bot-hoven/bot-hoven-electrical/README.md

# Bot-Hoven Electrical Repository

The electrical schematics for the bot-hoven hand PCB (left_hand) and controller PCB (mainpcb).
