bot-hoven/bot-hoven-electrical/Schematics/v1 As-Builts/Hand PCB v1 AS-BUILT.pdf

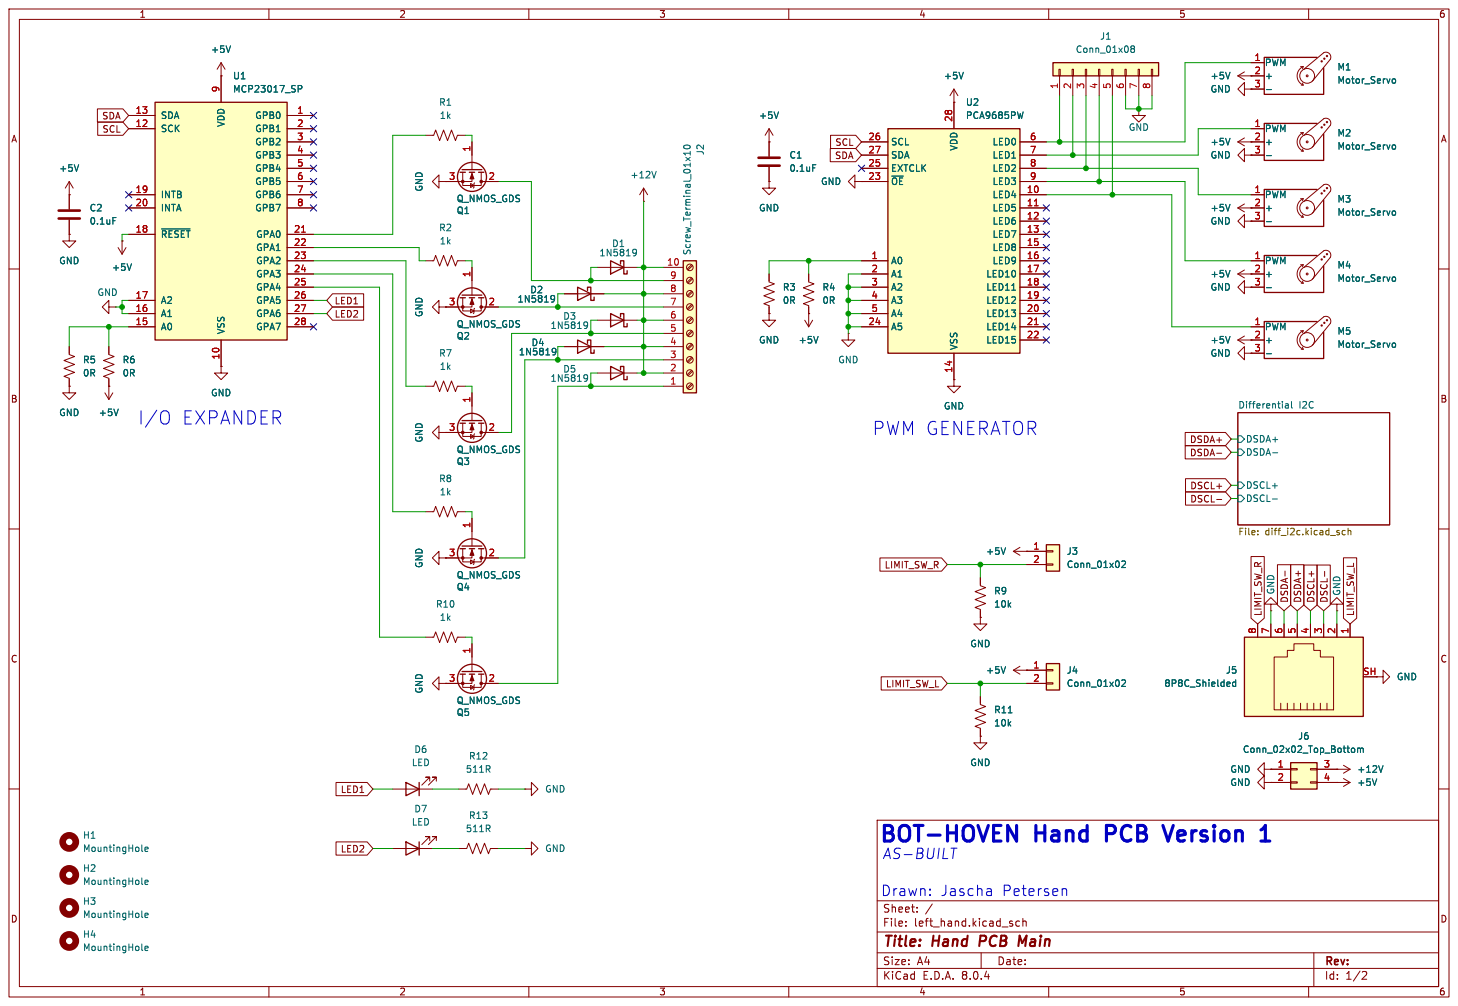
[picture p1: page 1]

BOT-HOVEN Hand PCB Version 1
AS-BUILT

Id: 1/2 Title: Hand PCB Main

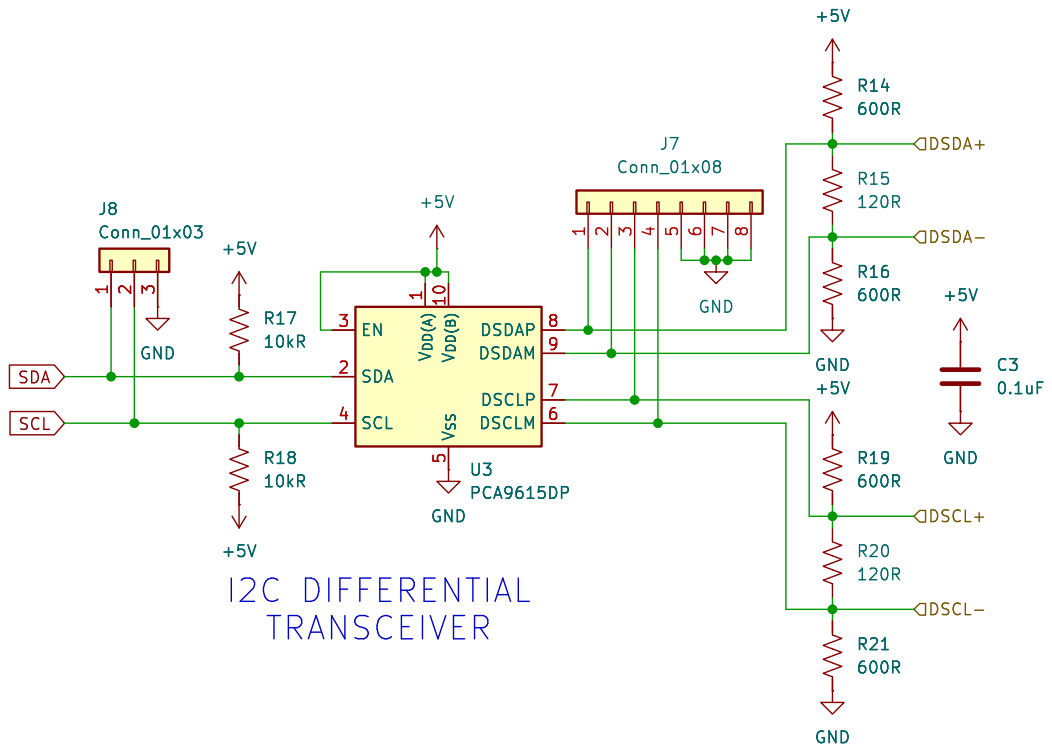
[picture p2: page 2]

DSCL- DSCL+ DSDA- DSDA+ SCL SDA
