bot-hoven/bot-hoven-electrical/Schematics/v1 As-Builts/Main PCB v1 AS-BUILT.pdf

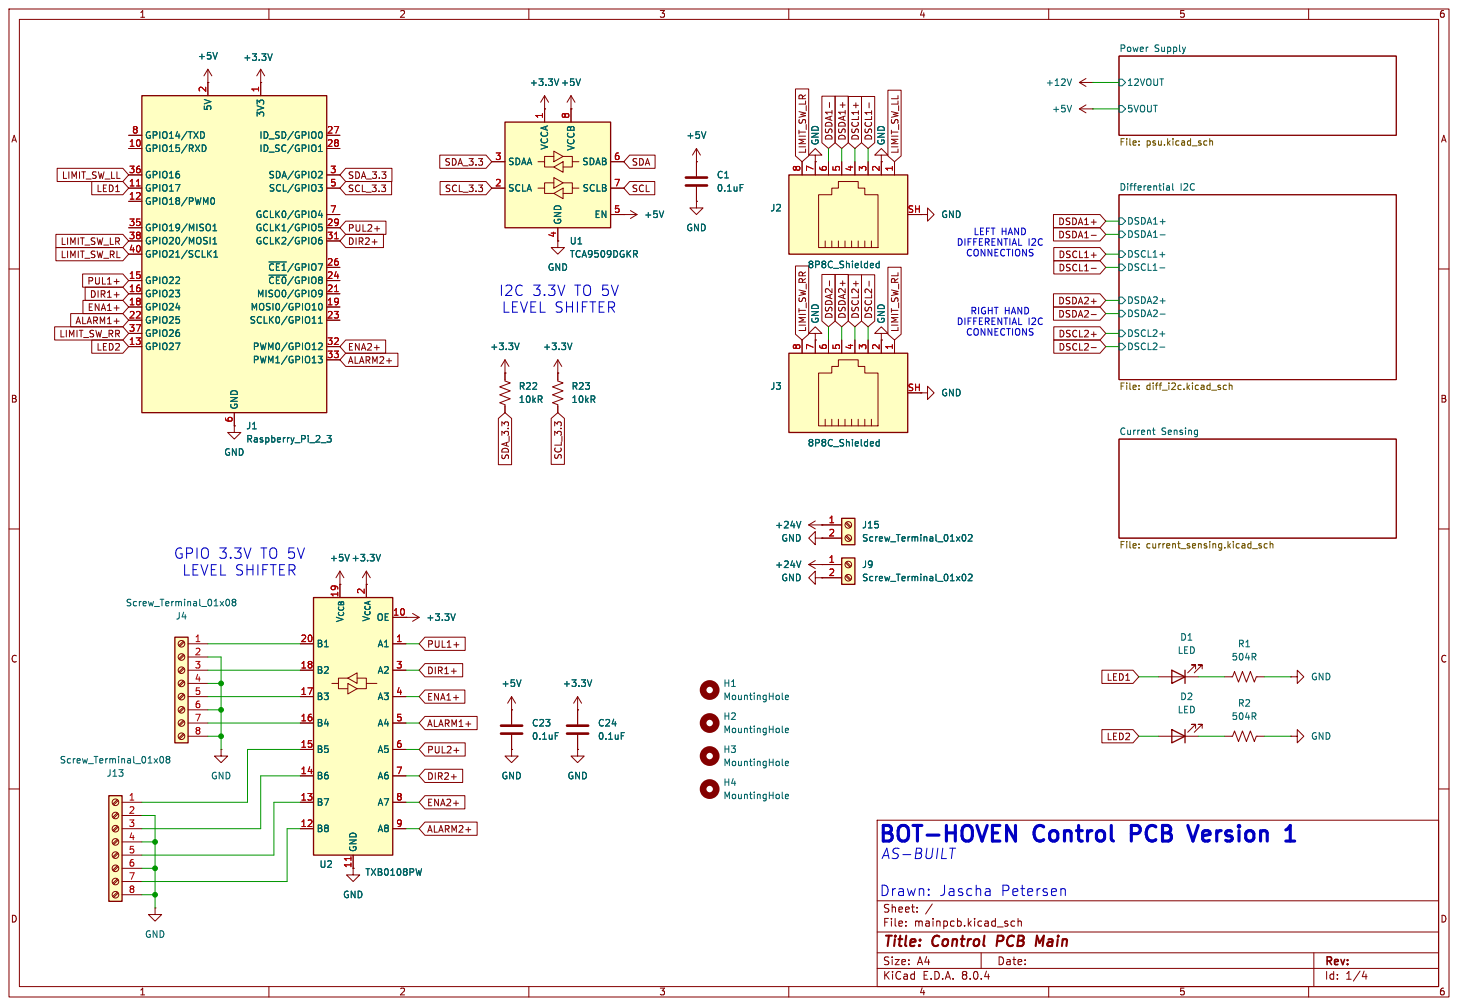
[picture p3: page 1]

6 GCLK0/GPIO4 7 GPIO14/TXD 8 GND GND GND

4 EN 5 SDAB 6 SCLB 7 VCCB

CONNECTIONS BOT-HOVEN Control PCB Version 1

Drawn: Jascha Petersen
File: mainpcb.kicad_sch Sheet: /
Id: 1/4 Title: Control PCB Main

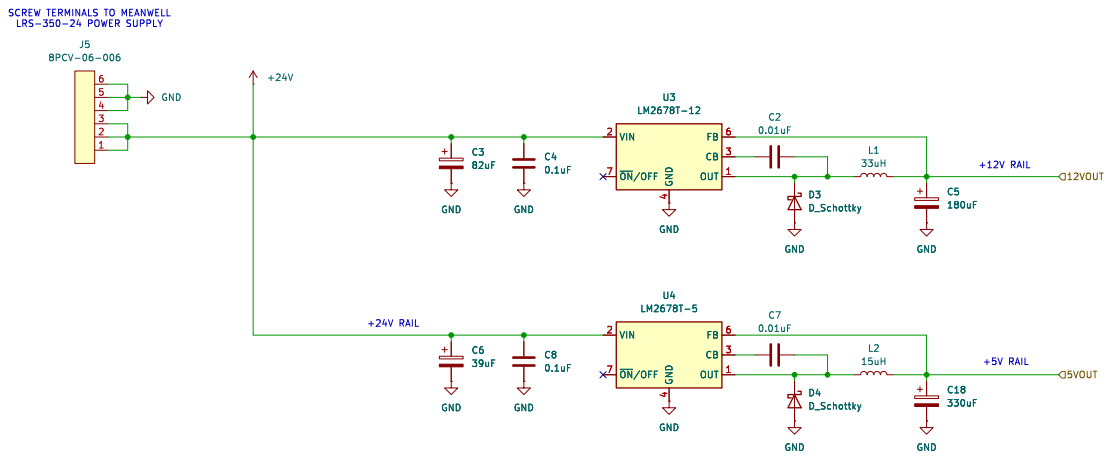
[picture p4: page 2]

SCREW TERMINALS TO MEANWELL

4 FB 6 ~{ON}/OFF 7 GND

+12V RAIL +5V RAIL AS-BUILT

Id: 2/4 Title: Control PCB PSU

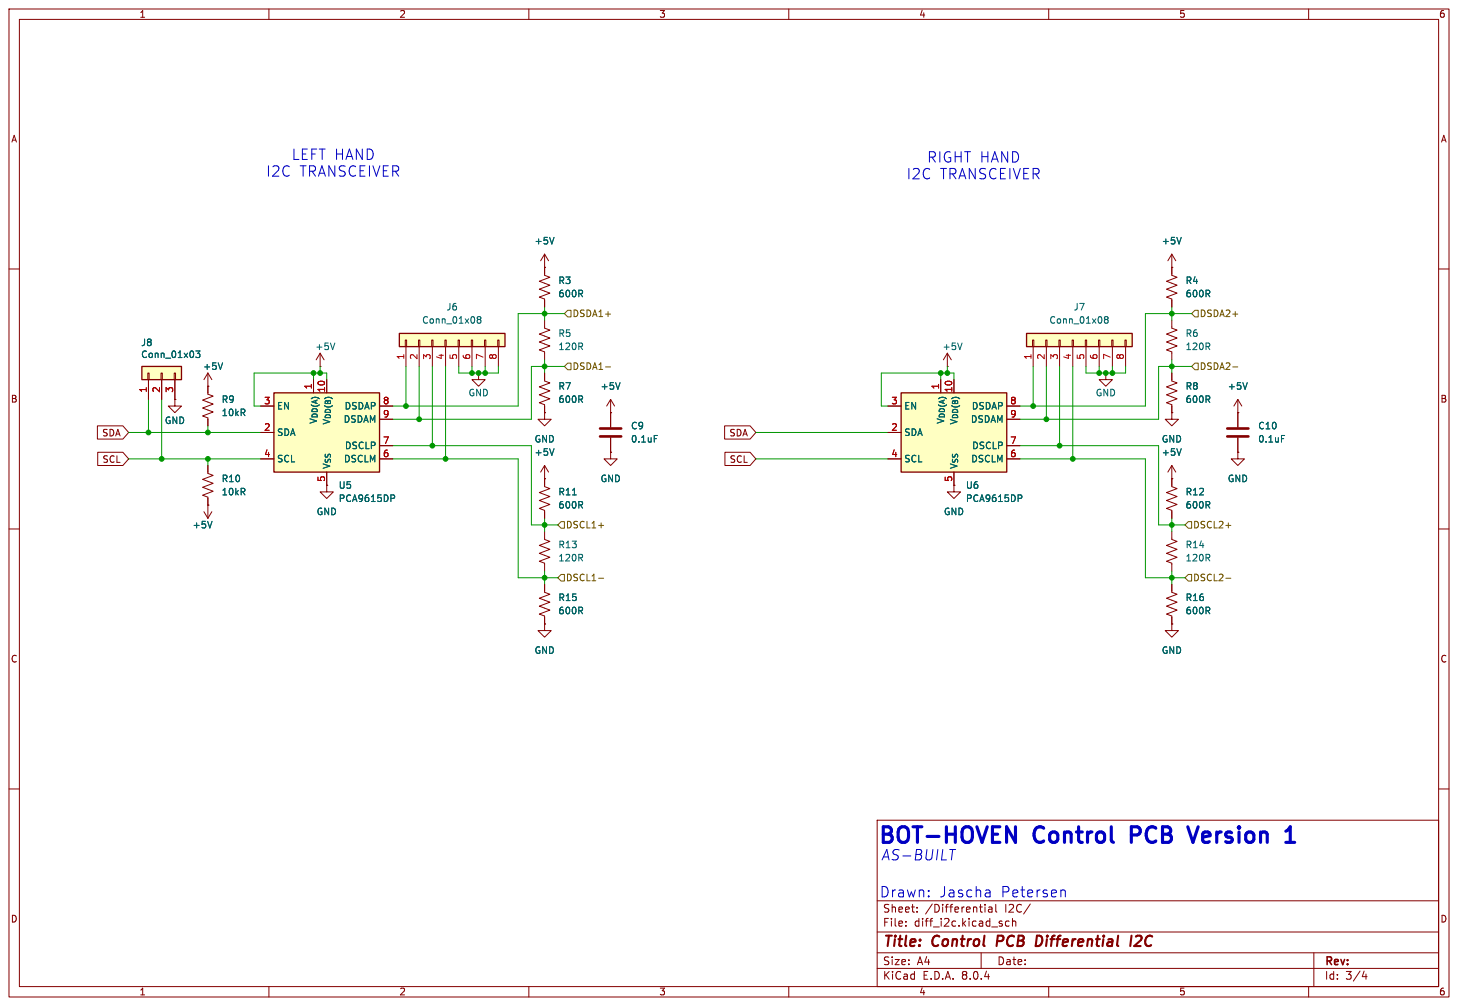
[picture p5: page 3]

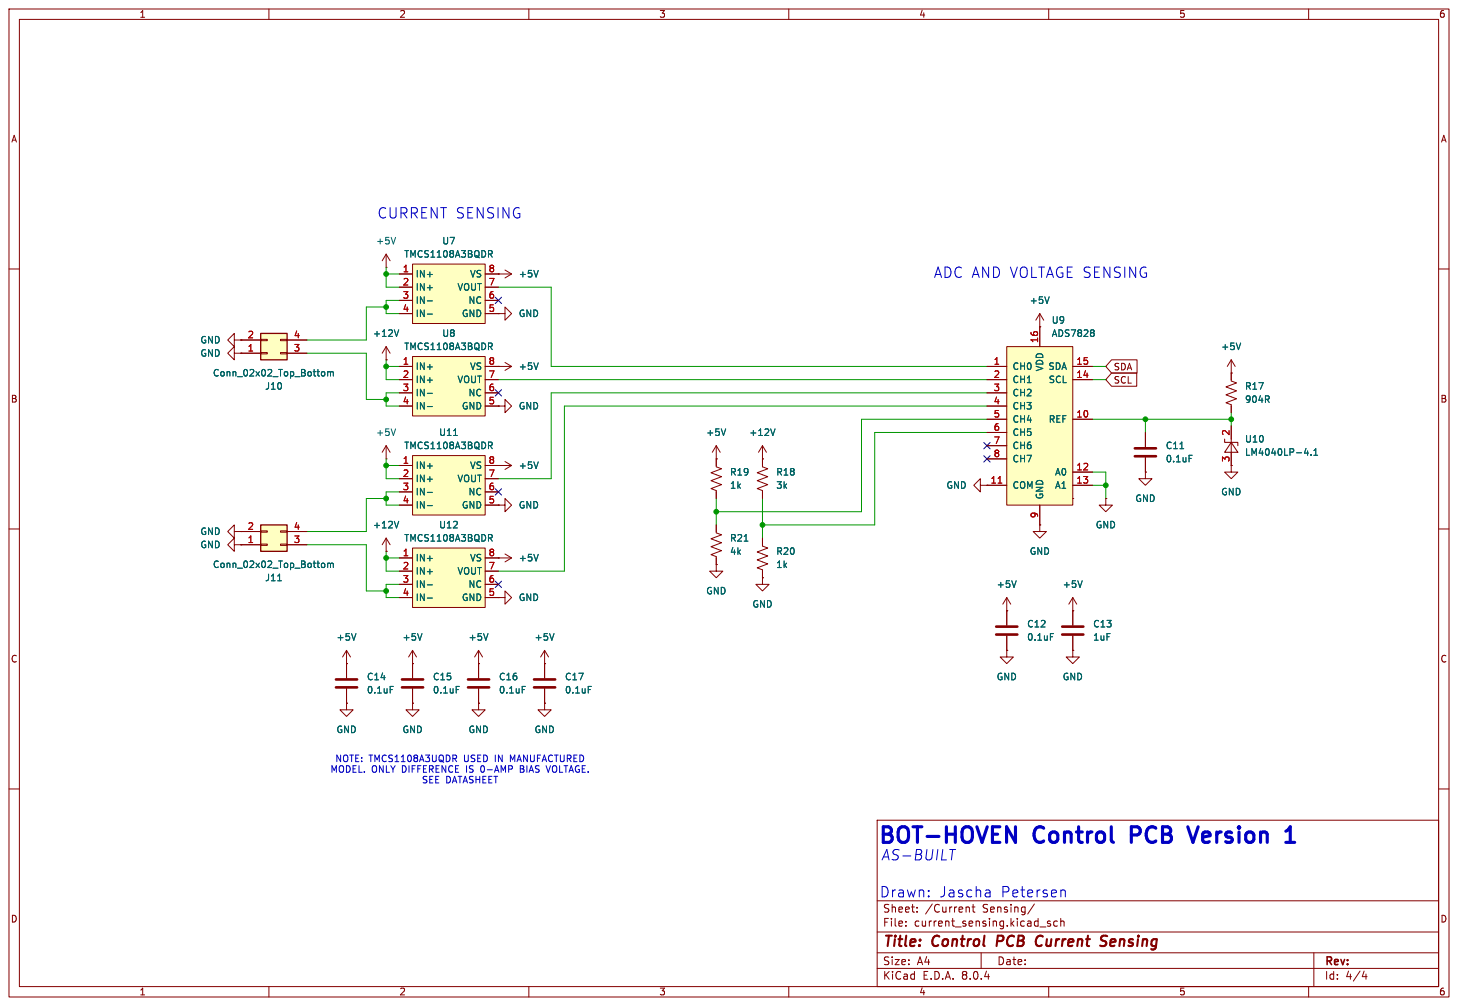
[picture p6: page 4]

2 3 U9ADS7828 CH0 1 REF 10 COM 11 A0 12 A1 13 SCL 14 SDA 15 VDD 16 CH1 2 CH2 3 CH3 4 CH4 5 CH5 6 CH6 7 CH7 8 GND

BOT-HOVEN Control PCB Version 1

Id: 4/4 Title: Control PCB Current Sensing
