bot-hoven/bot-hoven-electrical/v2/control_pcb/control_pcb.kicad_pcb

## KiCad design v2/control_pcb/control_pcb.kicad_pcb (2025-03-05)

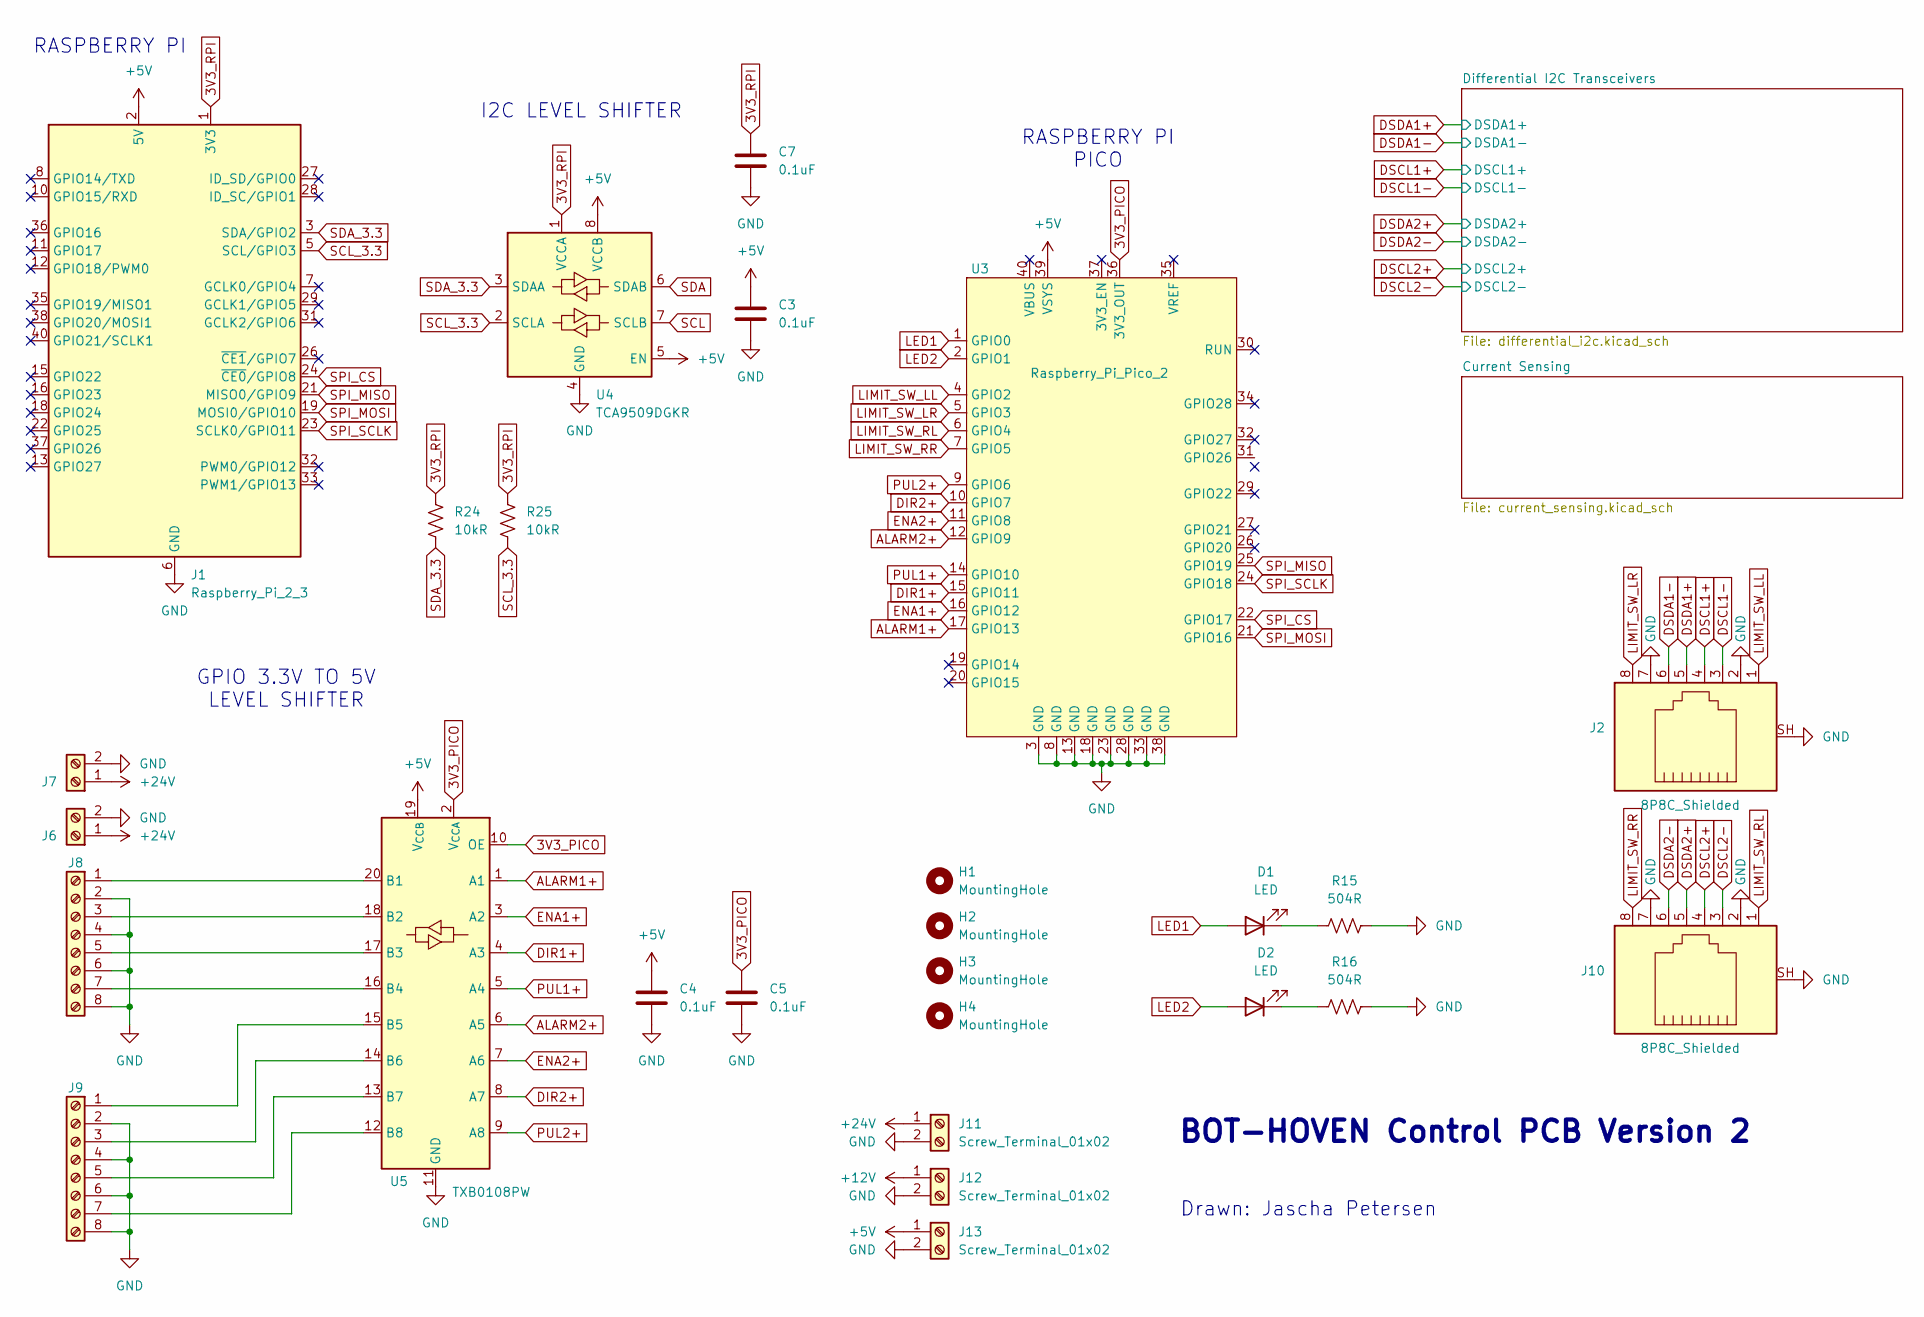
[picture p7: schematic control_pcb.kicad_sch]

Parts:
C3, C4, C5, C7: 0.1uF; C_Rect_L4.6mm_W2.0mm_P2.50mm_MKS02_FKP02
D1, D2: LED; LED_D5.0mm_Clear
H1, H2, H3, H4: MountingHole; MountingHole_4.3mm_M4
J1: Raspberry_Pi_2_3; PinHeader_2x20_P2.54mm_Vertical
J2, J10: 8P8C_Shielded; RJ45_Amphenol_54602-x08_Horizontal
J6, J7, J11, J12, J13: Screw_Terminal_01x02; TerminalBlock_Phoenix_PT-1,5-2-5.0-H_1x02_P5.00mm_Horizontal
J8, J9: Screw_Terminal_01x08; TerminalBlock_Phoenix_PT-1,5-8-5.0-H_1x08_P5.00mm_Horizontal
R15, R16: 504R; R_Axial_DIN0207_L6.3mm_D2.5mm_P10.16mm_Horizontal
R24, R25: 10kR; R_Axial_DIN0207_L6.3mm_D2.5mm_P10.16mm_Horizontal
U3: Raspberry_Pi_Pico_2; RaspberryPi_Pico_2_THT
U4: TCA9509DGKR; VSSOP-8_3x3mm_P0.65mm
U5: TXB0108PW; TSSOP-20_4.4x6.5mm_P0.65mm

Connections:
3V3_PICO: C5.1, U3.36 (3V3_OUT), U5.2 (V_{CCA}), U5.10 (OE)
3V3_RPI: C7.1, J1.1 (3V3), J1.17 (3V3), R24.1, R25.1, U4.1 (VCCA)
+5V: C3.1, C4.1, J1.2 (5V), J1.4 (5V), J13.1, U3.39 (VSYS), U4.5 (EN), U4.8 (VCCB), U5.19 (V_{CCB}); also elsewhere on the board
+12V: J12.1; also elsewhere on the board
+24V: J6.1, J7.1, J11.1; also elsewhere on the board
ALARM1+: U3.17 (GPIO13), U5.1 (A1)
ALARM2+: U3.12 (GPIO9), U5.6 (A5)
DIR1+: U3.15 (GPIO11), U5.4 (A3)
DIR2+: U3.10 (GPIO7), U5.8 (A7)
DSCL1+: J2.4; also elsewhere on the board
DSCL1-: J2.3; also elsewhere on the board
DSCL2+: J10.4; also elsewhere on the board
DSCL2-: J10.3; also elsewhere on the board
DSDA1+: J2.5; also elsewhere on the board
DSDA1-: J2.6; also elsewhere on the board
DSDA2+: J10.5; also elsewhere on the board
DSDA2-: J10.6; also elsewhere on the board
ENA1+: U3.16 (GPIO12), U5.3 (A2)
ENA2+: U3.11 (GPIO8), U5.7 (A6)
GND: C3.2, C4.2, C5.2, C7.2, J1.6 (GND), J1.9 (GND), J1.14 (GND), J1.20 (GND), J1.25 (GND), J1.30 (GND), J1.34 (GND), J1.39 (GND), J2.2, J2.7, J2.SH, J6.2, J7.2, J8.2, J8.4, J8.6, J8.8, J9.2, J9.4, J9.6, J9.8, J10.2, J10.7, J10.SH, J11.2, J12.2, J13.2, R15.2, R16.2, U3.3 (GND), U3.8 (GND), U3.13 (GND), U3.18 (GND), U3.23 (GND), U3.28 (GND), U3.33 (GND), U3.38 (GND), U4.4 (GND), U5.11 (GND); also elsewhere on the board
LED1: D1.2 (A), U3.1 (GPIO0)
LED2: D2.2 (A), U3.2 (GPIO1)
LIMIT_SW_LL: J2.1, U3.4 (GPIO2)
LIMIT_SW_LR: J2.8, U3.5 (GPIO3)
LIMIT_SW_RL: J10.1, U3.6 (GPIO4)
LIMIT_SW_RR: J10.8, U3.7 (GPIO5)
unnamed: D1.1 (K), R15.1
unnamed: D2.1 (K), R16.1
unnamed: J8.1, U5.20 (B1)
unnamed: J8.3, U5.18 (B2)
unnamed: J8.5, U5.17 (B3)
unnamed: J8.7, U5.16 (B4)
unnamed: J9.1, U5.15 (B5)
unnamed: J9.3, U5.14 (B6)
unnamed: J9.5, U5.13 (B7)
unnamed: J9.7, U5.12 (B8)
PUL1+: U3.14 (GPIO10), U5.5 (A4)
PUL2+: U3.9 (GPIO6), U5.9 (A8)
SCL: U4.7 (SCLB); also elsewhere on the board
SCL_3.3: J1.5 (SCL/GPIO3), R25.2, U4.2 (SCLA)
SDA: U4.6 (SDAB); also elsewhere on the board
SDA_3.3: J1.3 (SDA/GPIO2), R24.2, U4.3 (SDAA)
SPI_CS: J1.24 (~CE0/GPIO8), U3.22 (GPIO17)
SPI_MISO: J1.21 (MISO0/GPIO9), U3.25 (GPIO19)
SPI_MOSI: J1.19 (MOSI0/GPIO10), U3.21 (GPIO16)
SPI_SCLK: J1.23 (SCLK0/GPIO11), U3.24 (GPIO18)

Notes on the sheet:
BOT-HOVEN Control PCB Version 2
GPIO 3.3V TO 5V LEVEL SHIFTER
I2C LEVEL SHIFTER
Drawn: Jascha Petersen
RASPBERRY PI PICO
RASPBERRY PI

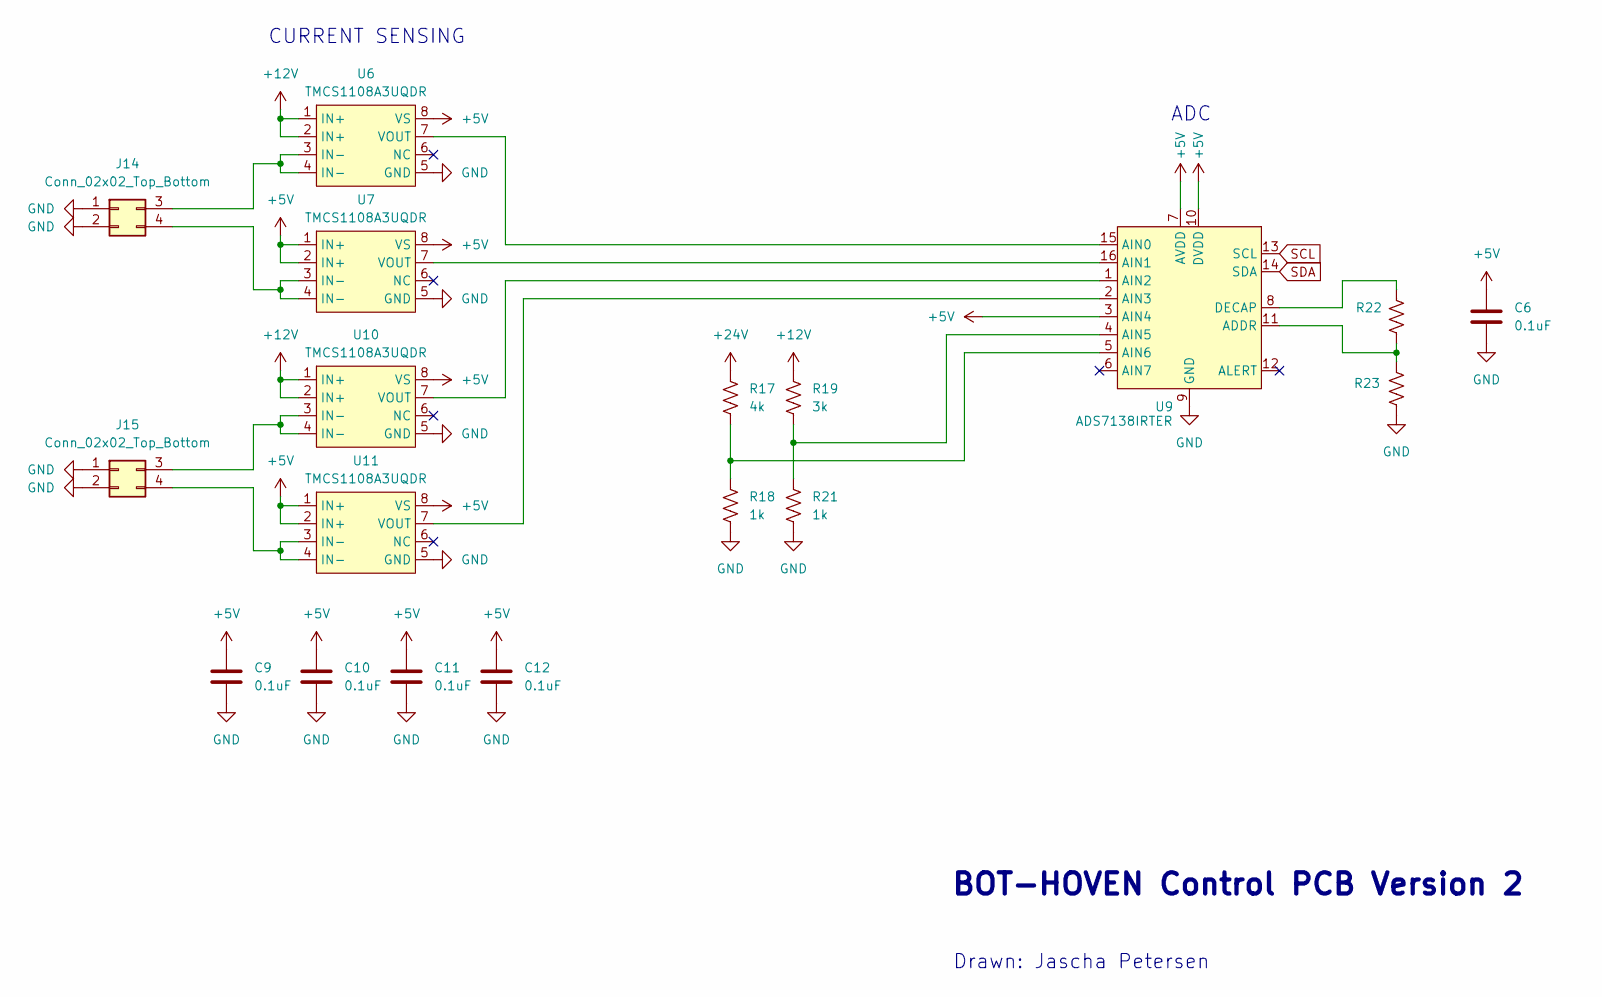
[picture p8: schematic current_sensing.kicad_sch]

Parts:
C6, C9, C10, C11, C12: 0.1uF; C_Rect_L4.6mm_W2.0mm_P2.50mm_MKS02_FKP02
J14, J15: Conn_02x02_Top_Bottom; Molex_Mini-Fit_Jr_5569-04A2_2x02_P4.20mm_Horizontal
R17: 4k; R_Axial_DIN0207_L6.3mm_D2.5mm_P10.16mm_Horizontal
R18, R21: 1k; R_Axial_DIN0207_L6.3mm_D2.5mm_P10.16mm_Horizontal
R19: 3k; R_Axial_DIN0207_L6.3mm_D2.5mm_P10.16mm_Horizontal
R22, R23: 0R; R_Axial_DIN0207_L6.3mm_D2.5mm_P10.16mm_Horizontal
U6, U7, U10, U11: TMCS1108A3UQDR; SOIC-8_3.9x4.9mm_P1.27mm
U9: ADS7138IRTER; WQFN-16-1EP_3x3mm_P0.5mm_EP1.68x1.68mm

Connections:
+5V: C6.1, C9.1, C10.1, C11.1, C12.1, U6.8 (VS), U7.1 (IN+), U7.2 (IN+), U7.8 (VS), U9.3 (AIN4), U9.7 (AVDD), U9.10 (DVDD), U10.8 (VS), U11.1 (IN+), U11.2 (IN+), U11.8 (VS); also elsewhere on the board
+12V: R19.1, U6.1 (IN+), U6.2 (IN+), U10.1 (IN+), U10.2 (IN+); also elsewhere on the board
+24V: R17.1; also elsewhere on the board
GND: C6.2, C9.2, C10.2, C11.2, C12.2, J14.1, J14.2, J15.1, J15.2, R18.2, R21.2, R23.2, U6.5 (GND), U7.5 (GND), U9.9 (GND), U10.5 (GND), U11.5 (GND); also elsewhere on the board
unnamed: J14.3, U6.3 (IN-), U6.4 (IN-)
unnamed: J14.4, U7.3 (IN-), U7.4 (IN-)
unnamed: J15.3, U10.3 (IN-), U10.4 (IN-)
unnamed: J15.4, U11.3 (IN-), U11.4 (IN-)
unnamed: U6.7 (VOUT), U9.15 (AIN0)
unnamed: U7.7 (VOUT), U9.16 (AIN1)
unnamed: R22.2, R23.1, U9.11 (ADDR)
unnamed: R19.2, R21.1, U9.4 (AIN5)
unnamed: R17.2, R18.1, U9.5 (AIN6)
unnamed: R22.1, U9.8 (DECAP)
unnamed: U9.1 (AIN2), U10.7 (VOUT)
unnamed: U9.2 (AIN3), U11.7 (VOUT)
SCL: U9.13 (SCL); also elsewhere on the board
SDA: U9.14 (SDA); also elsewhere on the board

Notes on the sheet:
ADC
CURRENT SENSING
Drawn: Jascha Petersen
BOT-HOVEN Control PCB Version 2

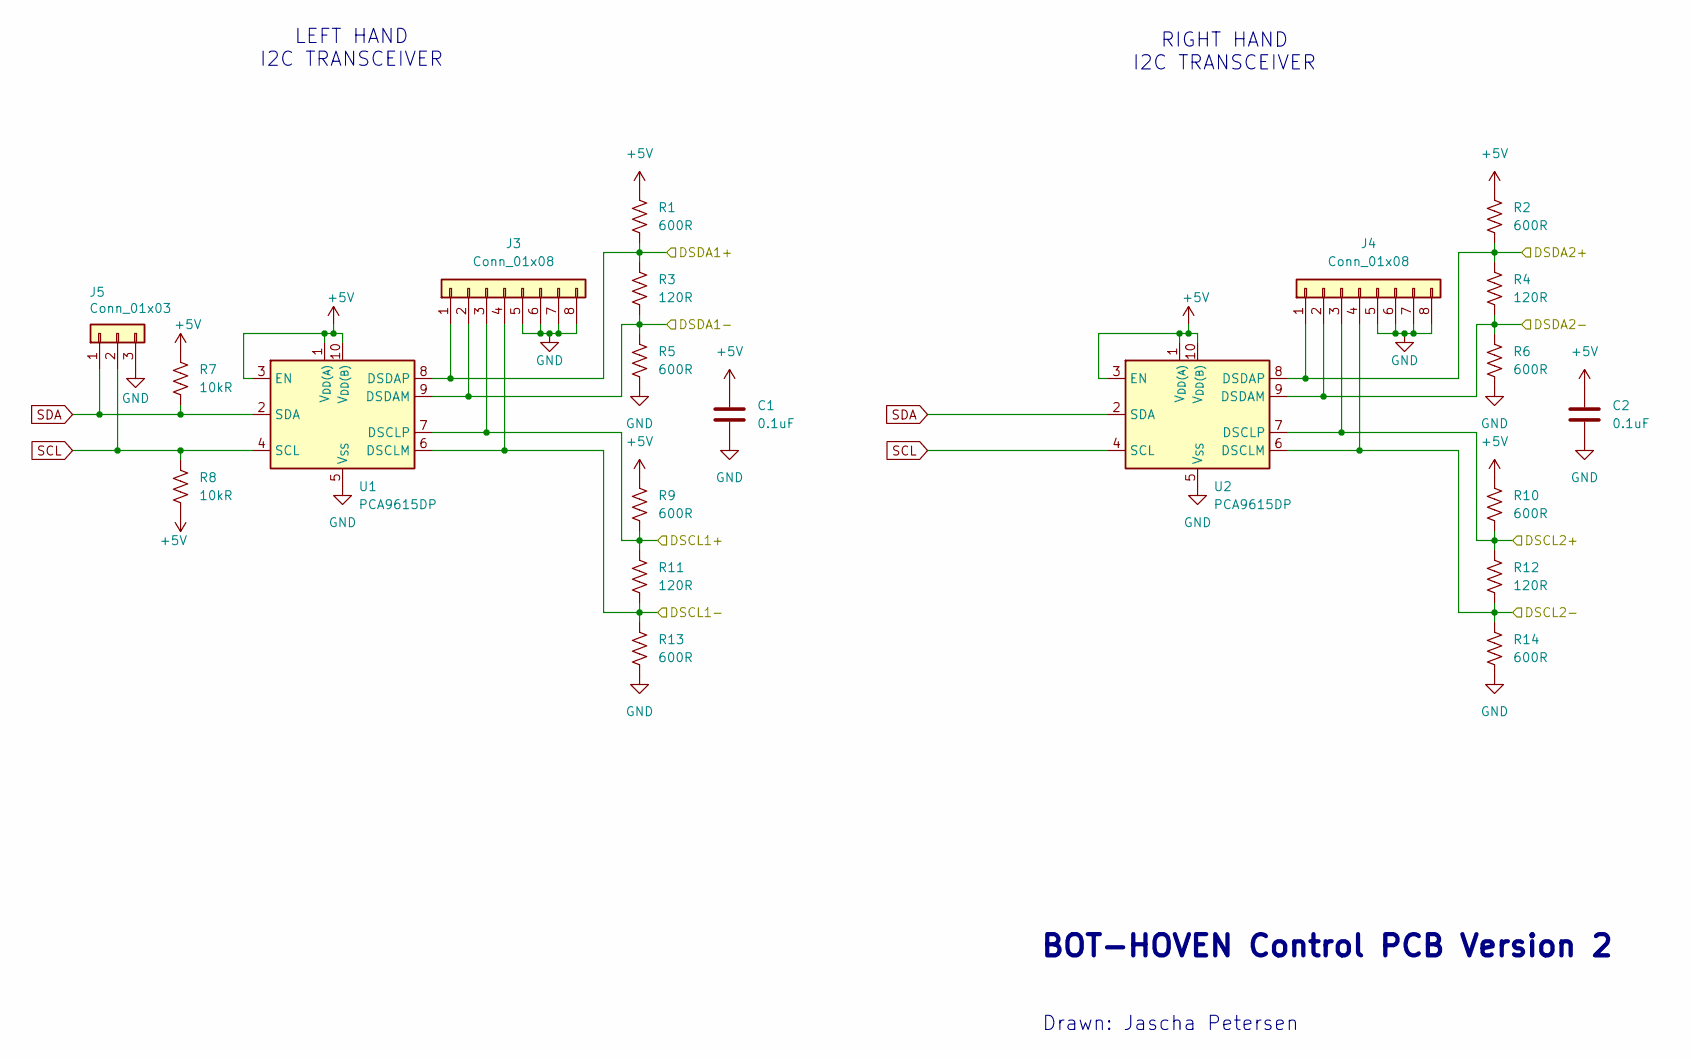
[picture p9: schematic differential_i2c.kicad_sch]

Parts:
C1, C2: 0.1uF; C_Rect_L4.6mm_W2.0mm_P2.50mm_MKS02_FKP02
J3, J4: Conn_01x08; PinHeader_1x08_P2.54mm_Vertical
J5: Conn_01x03; PinHeader_1x03_P2.54mm_Vertical
R1, R2, R5, R6, R9, R10, R13, R14: 600R; R_Axial_DIN0207_L6.3mm_D2.5mm_P10.16mm_Horizontal
R3, R4, R11, R12: 120R; R_Axial_DIN0207_L6.3mm_D2.5mm_P10.16mm_Horizontal
R7, R8: 10kR; R_Axial_DIN0207_L6.3mm_D2.5mm_P10.16mm_Horizontal
U1, U2: PCA9615DP; TSSOP-10_3x3mm_P0.5mm

Connections:
+5V: C1.1, C2.1, R1.1, R2.1, R7.1, R8.2, R9.1, R10.1, U1.1 (V_{DD(A)}), U1.3 (EN), U1.10 (V_{DD(B)}), U2.1 (V_{DD(A)}), U2.3 (EN), U2.10 (V_{DD(B)}); also elsewhere on the board
DSCL1+: J3.3, R9.2, R11.1, U1.7 (DSCLP); also elsewhere on the board
DSCL1-: J3.4, R11.2, R13.1, U1.6 (DSCLM); also elsewhere on the board
DSCL2+: J4.3, R10.2, R12.1, U2.7 (DSCLP); also elsewhere on the board
DSCL2-: J4.4, R12.2, R14.1, U2.6 (DSCLM); also elsewhere on the board
DSDA1+: J3.1, R1.2, R3.1, U1.8 (DSDAP); also elsewhere on the board
DSDA1-: J3.2, R3.2, R5.1, U1.9 (DSDAM); also elsewhere on the board
DSDA2+: J4.1, R2.2, R4.1, U2.8 (DSDAP); also elsewhere on the board
DSDA2-: J4.2, R4.2, R6.1, U2.9 (DSDAM); also elsewhere on the board
GND: C1.2, C2.2, J3.5, J3.6, J3.7, J3.8, J4.5, J4.6, J4.7, J4.8, J5.3, R5.2, R6.2, R13.2, R14.2, U1.5 (V_{SS}), U2.5 (V_{SS}); also elsewhere on the board
SCL: J5.2, R8.1, U1.4 (SCL), U2.4 (SCL); also elsewhere on the board
SDA: J5.1, R7.2, U1.2 (SDA), U2.2 (SDA); also elsewhere on the board

Notes on the sheet:
BOT-HOVEN Control PCB Version 2
RIGHT HAND I2C TRANSCEIVER
LEFT HAND I2C TRANSCEIVER
Drawn: Jascha Petersen

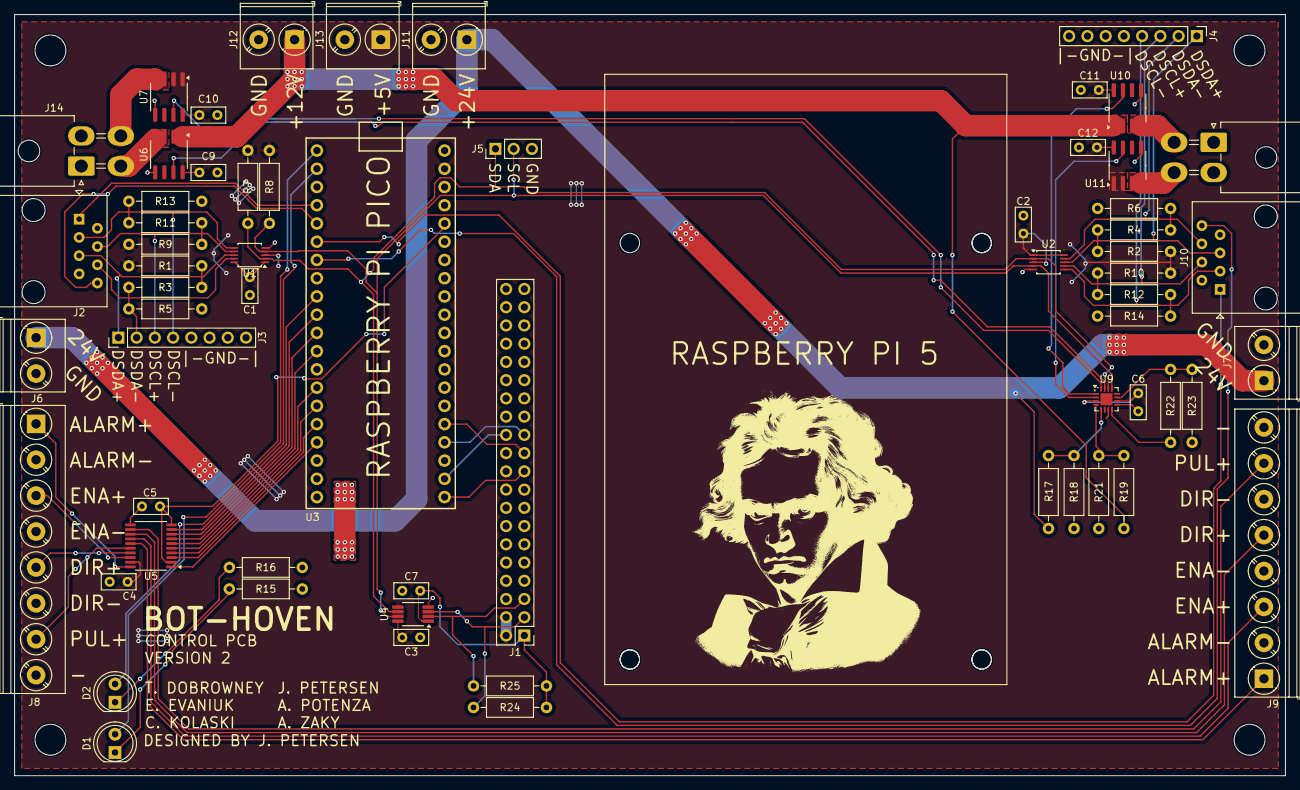
[picture p10: board control_pcb.kicad_pcb from above]

Board: 2 copper layers, 177.0 x 106.0 mm, 66 parts (0 on the bottom side), 58 nets.
