bot-hoven/bot-hoven-electrical/v2/hand_pcb/hand_pcb.kicad_pcb

## KiCad design v2/hand_pcb/hand_pcb.kicad_pcb (2025-03-05)

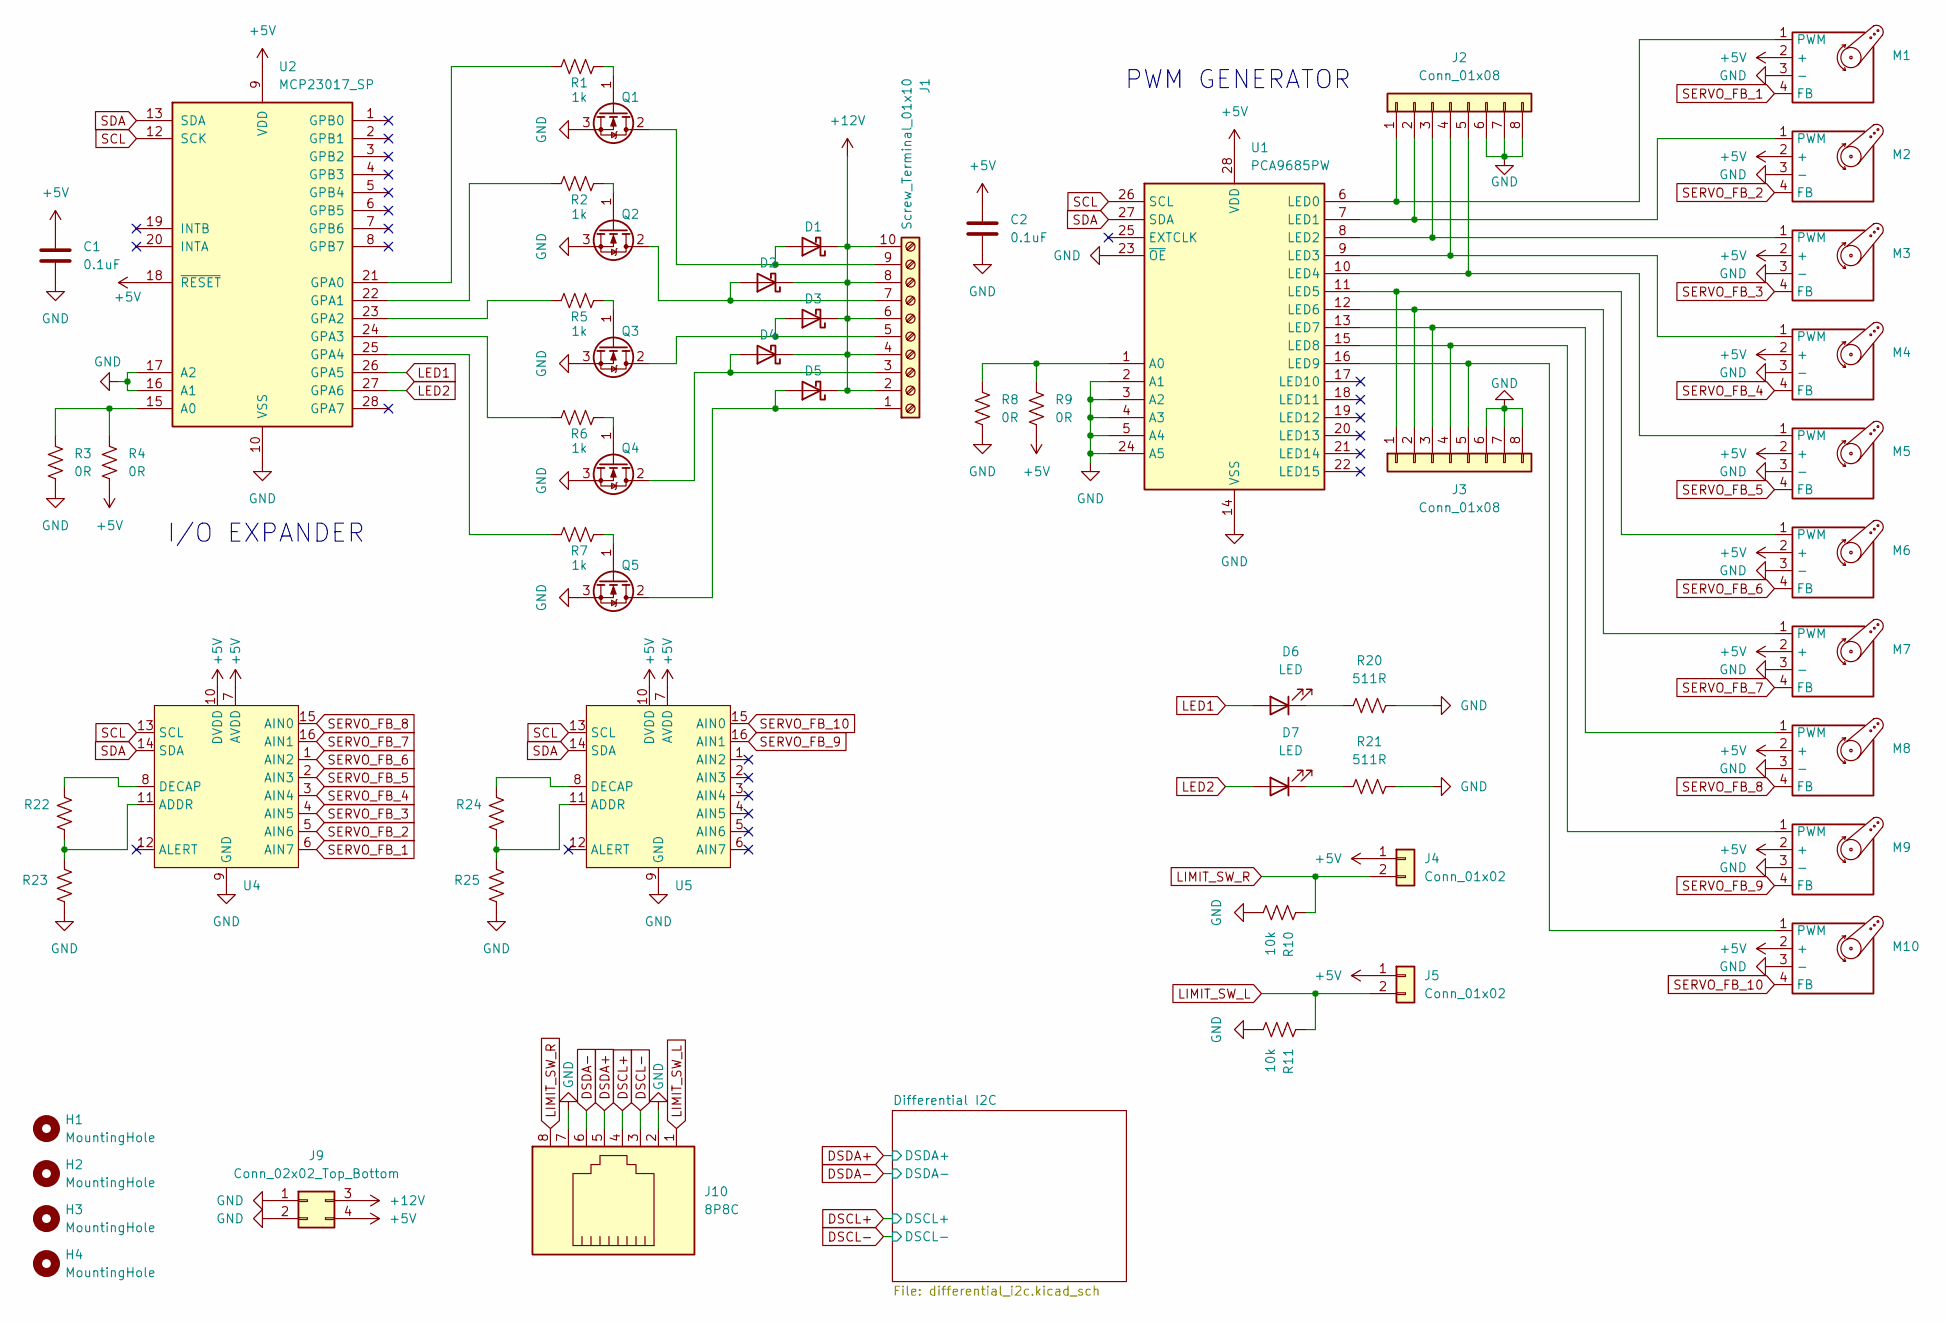
[picture p11: schematic hand_pcb.kicad_sch]

Parts:
C1, C2: 0.1uF; C_Disc_D3.4mm_W2.1mm_P2.50mm
D1, D2, D3, D4, D5: SB5100-T; D_DO-201AD_P12.70mm_Horizontal
D6, D7: LED; LED_D5.0mm_Clear
H1, H2, H3, H4: MountingHole; MountingHole_3.2mm_M3
J1: Screw_Terminal_01x10; TerminalBlock_Phoenix_PT-1,5-10-5.0-H_1x10_P5.00mm_Horizont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
J2, J3: Conn_01x08; PinHeader_1x08_P2.54mm_Vertical
J4, J5: Conn_01x02; JST_XH_S2B-XH-A_1x02_P2.50mm_Horizontal
J9: Conn_02x02_Top_Bottom; Molex_Mini-Fit_Jr_5569-04A2_2x02_P4.20mm_Horizontal
J10: 8P8C; RJ45_Amphenol_54602-x08_Horizontal
M1, M2, M3, M4, M5, M6, M7, M8, M9, M10: Motor_Servo_FB; PinHeader_1x04_P2.54mm_Vertical
Q1, Q2, Q3, Q4, Q5: Q_NMOS_GDS; TO-220-3_Vertical
R1, R2, R5, R6, R7: 1k; R_Axial_DIN0207_L6.3mm_D2.5mm_P10.16mm_Horizontal
R3, R4, R8, R9, R22, R23, R24, R25: 0R; R_Axial_DIN0207_L6.3mm_D2.5mm_P10.16mm_Horizontal
R10, R11: 10k; R_Axial_DIN0207_L6.3mm_D2.5mm_P10.16mm_Horizontal
R20, R21: 511R; R_Axial_DIN0207_L6.3mm_D2.5mm_P10.16mm_Horizontal
U1: PCA9685PW; TSSOP-28_4.4x9.7mm_P0.65mm
U2: MCP23017_SP; DIP-28_W7.62mm
U4, U5: WQFN-16-1EP_3x3mm_P0.5mm_EP1.68x1.68mm

Connections:
+5V: C1.1, C2.1, J4.1, J5.1, J9.4, M1.2 (+), M2.2 (+), M3.2 (+), M4.2 (+), M5.2 (+), M6.2 (+), M7.2 (+), M8.2 (+), M9.2 (+), M10.2 (+), R4.2, R9.2, U1.28 (VDD), U2.9 (VDD), U2.18 (~RESET), U4.7 (AVDD), U4.10 (DVDD), U5.7 (AVDD), U5.10 (DVDD); also elsewhere on the board
+12V: D1.1 (K), D2.1 (K), D3.1 (K), D4.1 (K), D5.1 (K), J1.2, J1.4, J1.6, J1.8, J1.10, J9.3
DSCL+: J10.4; also elsewhere on the board
DSCL-: J10.3; also elsewhere on the board
DSDA+: J10.5; also elsewhere on the board
DSDA-: J10.6; also elsewhere on the board
GND: C1.2, C2.2, J2.6, J2.7, J2.8, J3.6, J3.7, J3.8, J9.1, J9.2, J10.2, J10.7, M1.3 (-), M2.3 (-), M3.3 (-), M4.3 (-), M5.3 (-), M6.3 (-), M7.3 (-), M8.3 (-), M9.3 (-), M10.3 (-), Q1.3 (S), Q2.3 (S), Q3.3 (S), Q4.3 (S), Q5.3 (S), R3.2, R8.2, R10.1, R11.1, R20.2, R21.2, R23.2, R25.2, U1.2 (A1), U1.3 (A2), U1.4 (A3), U1.5 (A4), U1.14 (VSS), U1.23 (~OE), U1.24 (A5), U2.10 (VSS), U2.16 (A1), U2.17 (A2), U4.9 (GND), U5.9 (GND); also elsewhere on the board
LED1: D6.2 (A), U2.26 (GPA5)
LED2: D7.2 (A), U2.27 (GPA6)
LIMIT_SW_L: J5.2, J10.1, R11.2
LIMIT_SW_R: J4.2, J10.8, R10.2
unnamed: D1.2 (A), J1.9, Q1.2 (D)
unnamed: D2.2 (A), J1.7, Q2.2 (D)
unnamed: D3.2 (A), J1.5, Q3.2 (D)
unnamed: D4.2 (A), J1.3, Q4.2 (D)
unnamed: D5.2 (A), J1.1, Q5.2 (D)
unnamed: D6.1 (K), R20.1
unnamed: D7.1 (K), R21.1
unnamed: J2.1, M1.1 (PWM), U1.6 (LED0)
unnamed: J2.2, M2.1 (PWM), U1.7 (LED1)
unnamed: J2.3, M3.1 (PWM), U1.8 (LED2)
unnamed: J2.4, M4.1 (PWM), U1.9 (LED3)
unnamed: J2.5, M5.1 (PWM), U1.10 (LED4)
unnamed: J3.1, M6.1 (PWM), U1.11 (LED5)
unnamed: J3.2, M7.1 (PWM), U1.12 (LED6)
unnamed: J3.3, M8.1 (PWM), U1.13 (LED7)
unnamed: J3.4, M9.1 (PWM), U1.15 (LED8)
unnamed: J3.5, M10.1 (PWM), U1.16 (LED9)
unnamed: Q1.1 (G), R1.2
unnamed: Q2.1 (G), R2.2
unnamed: Q3.1 (G), R5.2
unnamed: Q4.1 (G), R6.2
unnamed: Q5.1 (G), R7.2
unnamed: R8.1, R9.1, U1.1 (A0)
unnamed: R3.1, R4.1, U2.15 (A0)
unnamed: R1.1, U2.21 (GPA0)
unnamed: R2.1, U2.22 (GPA1)
unnamed: R5.1, U2.23 (GPA2)
unnamed: R6.1, U2.24 (GPA3)
unnamed: R7.1, U2.25 (GPA4)
unnamed: R22.2, R23.1, U4.11 (ADDR)
unnamed: R22.1, U4.8 (DECAP)
unnamed: R24.2, R25.1, U5.11 (ADDR)
unnamed: R24.1, U5.8 (DECAP)
SCL: U1.26 (SCL), U2.12 (SCK), U4.13 (SCL), U5.13 (SCL); also elsewhere on the board
SDA: U1.27 (SDA), U2.13 (SDA), U4.14 (SDA), U5.14 (SDA); also elsewhere on the board
SERVO_FB_1: M1.4 (FB), U4.6 (AIN7)
SERVO_FB_2: M2.4 (FB), U4.5 (AIN6)
SERVO_FB_3: M3.4 (FB), U4.4 (AIN5)
SERVO_FB_4: M4.4 (FB), U4.3 (AIN4)
SERVO_FB_5: M5.4 (FB), U4.2 (AIN3)
SERVO_FB_6: M6.4 (FB), U4.1 (AIN2)
SERVO_FB_7: M7.4 (FB), U4.16 (AIN1)
SERVO_FB_8: M8.4 (FB), U4.15 (AIN0)
SERVO_FB_9: M9.4 (FB), U5.16 (AIN1)
SERVO_FB_10: M10.4 (FB), U5.15 (AIN0)

Notes on the sheet:
I/O EXPANDER
PWM GENERATOR

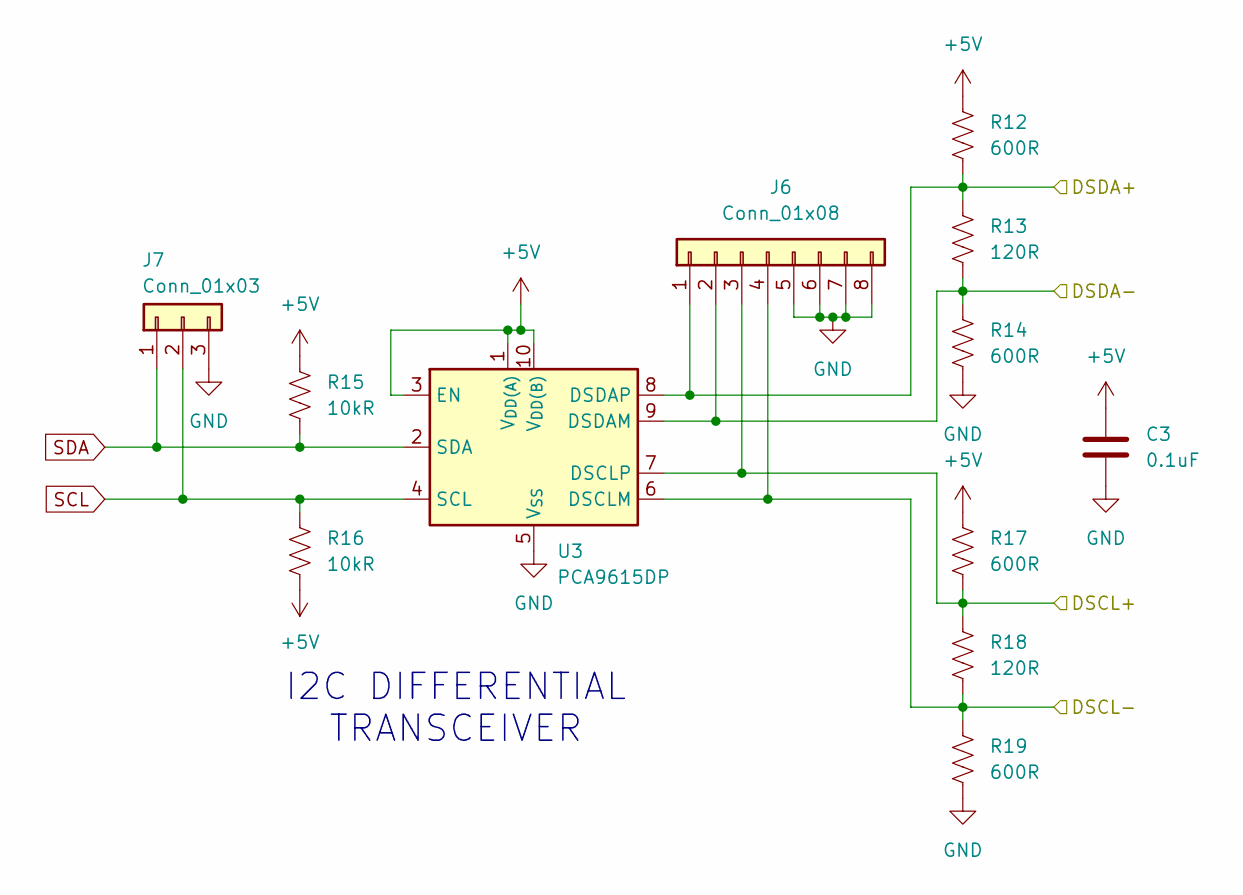
[picture p12: schematic differential_i2c.kicad_sch]

Parts:
C3: 0.1uF; C_Disc_D3.4mm_W2.1mm_P2.50mm
J6: Conn_01x08; PinHeader_1x08_P2.54mm_Vertical
J7: Conn_01x03; PinHeader_1x03_P2.54mm_Vertical
R12, R14, R17, R19: 600R; R_Axial_DIN0207_L6.3mm_D2.5mm_P10.16mm_Horizontal
R13, R18: 120R; R_Axial_DIN0207_L6.3mm_D2.5mm_P10.16mm_Horizontal
R15, R16: 10kR; R_Axial_DIN0207_L6.3mm_D2.5mm_P10.16mm_Horizontal
U3: PCA9615DP; TSSOP-10_3x3mm_P0.5mm

Connections:
+5V: C3.1, R12.1, R15.1, R16.2, R17.1, U3.1 (V_{DD(A)}), U3.3 (EN), U3.10 (V_{DD(B)}); also elsewhere on the board
DSCL+: J6.3, R17.2, R18.1, U3.7 (DSCLP); also elsewhere on the board
DSCL-: J6.4, R18.2, R19.1, U3.6 (DSCLM); also elsewhere on the board
DSDA+: J6.1, R12.2, R13.1, U3.8 (DSDAP); also elsewhere on the board
DSDA-: J6.2, R13.2, R14.1, U3.9 (DSDAM); also elsewhere on the board
GND: C3.2, J6.5, J6.6, J6.7, J6.8, J7.3, R14.2, R19.2, U3.5 (V_{SS}); also elsewhere on the board
SCL: J7.2, R16.1, U3.4 (SCL); also elsewhere on the board
SDA: J7.1, R15.2, U3.2 (SDA); also elsewhere on the board

Notes on the sheet:
I2C DIFFERENTIAL TRANSCEIVER

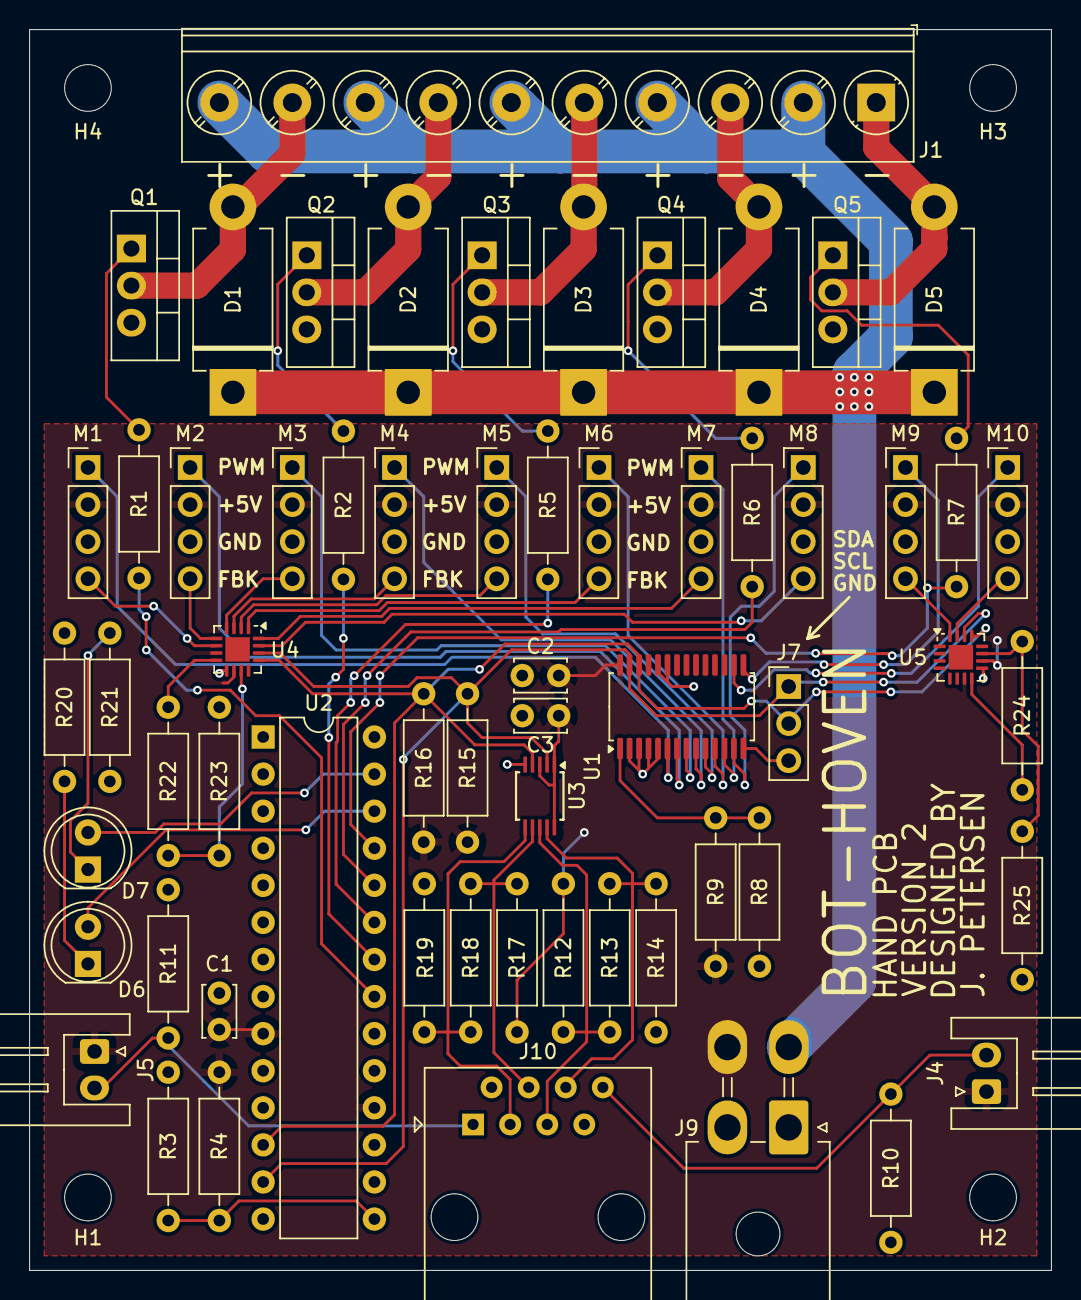
[picture p13: board hand_pcb.kicad_pcb from above]

Board: 2 copper layers, 70.0 x 85.0 mm, 65 parts (0 on the bottom side), 56 nets.
