bot-hoven/bot-hoven-electrical/v1/left_hand/left_hand.kicad_pcb

## KiCad design v1/left_hand/left_hand.kicad_pcb (2024-12-06, an earlier design)

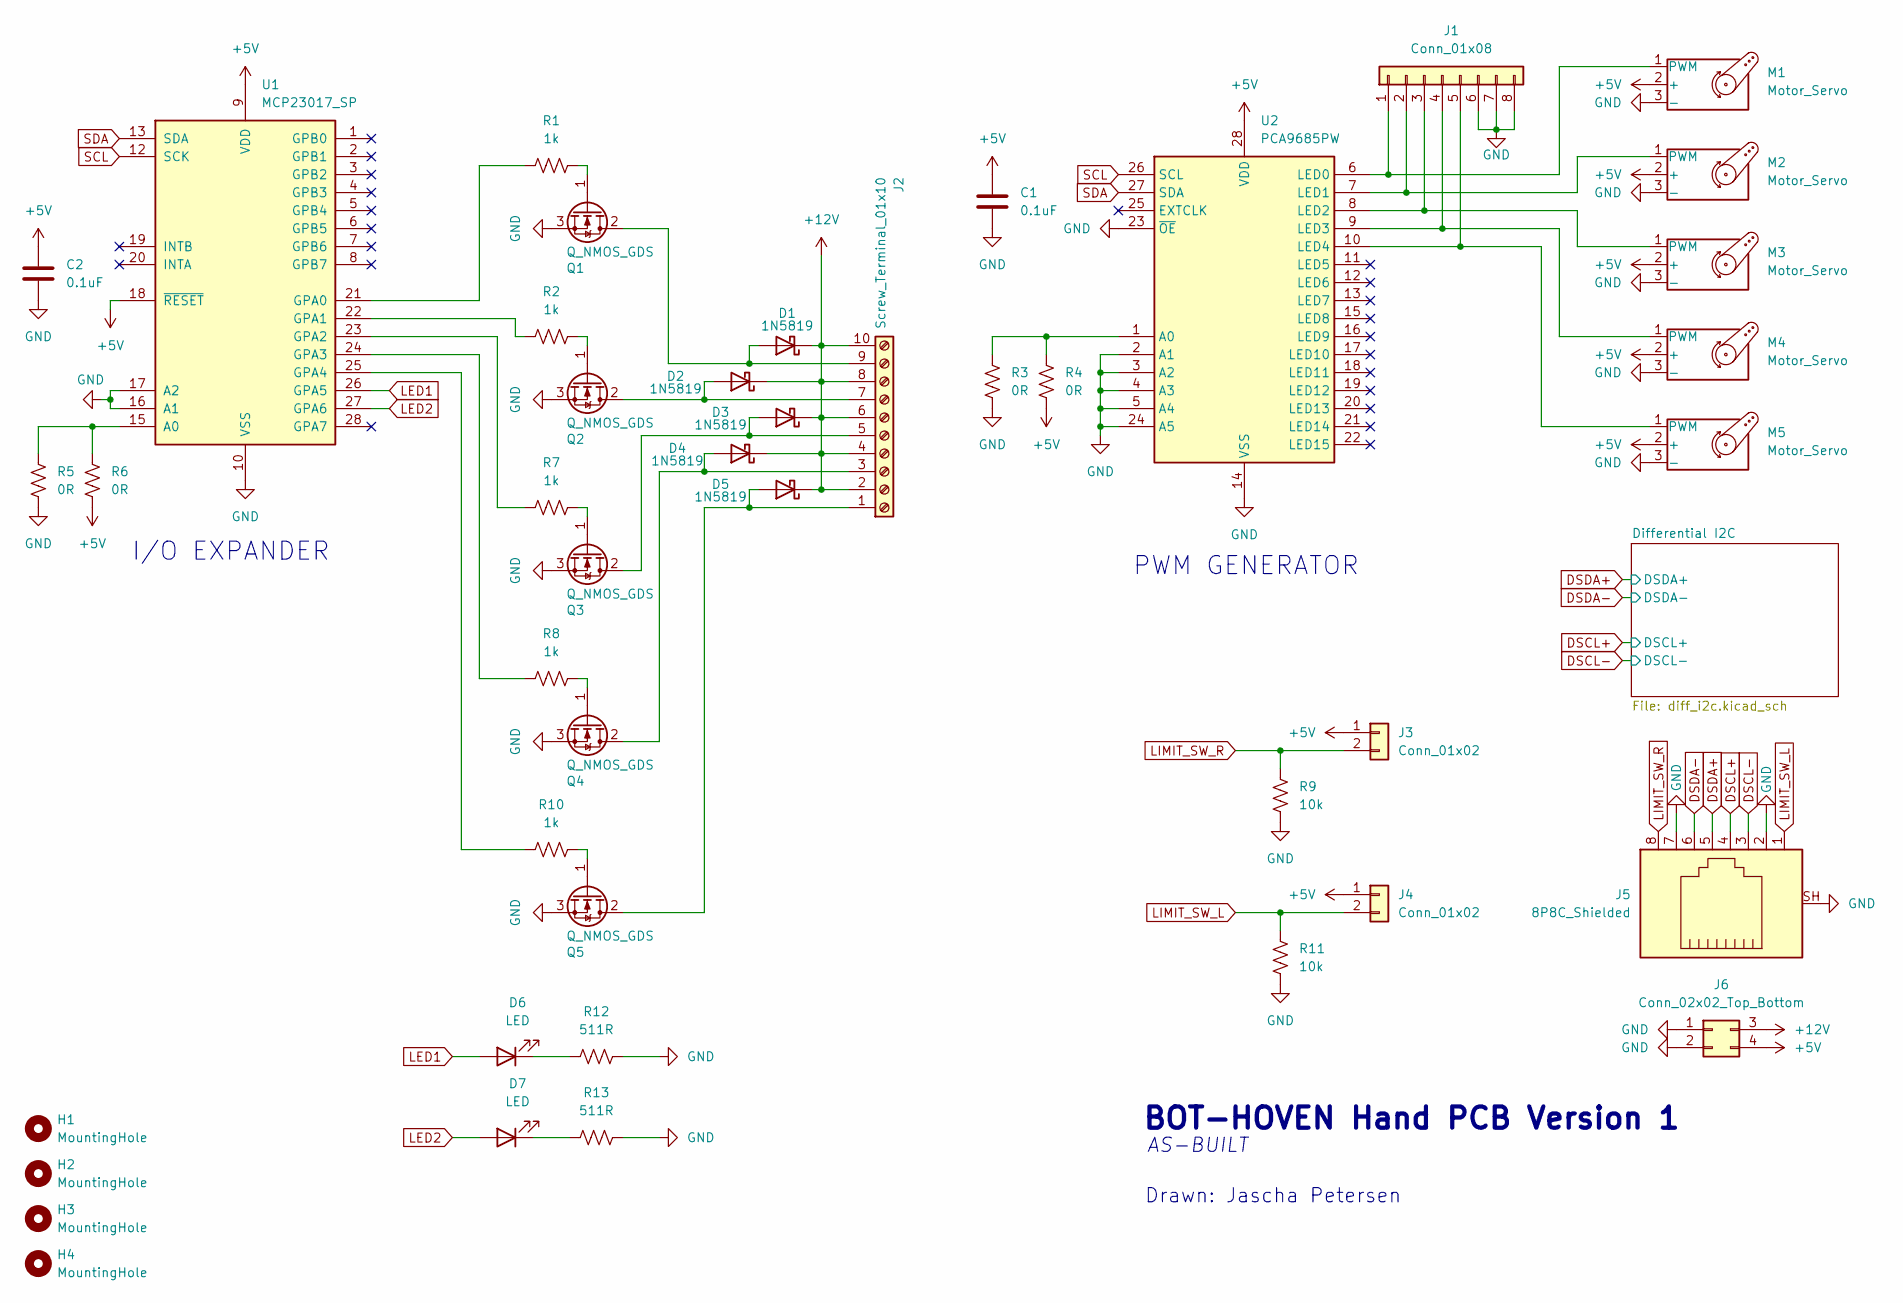
[picture p14: schematic left_hand.kicad_sch, Hand PCB Main]

Parts:
C1, C2: 0.1uF; C_Disc_D3.4mm_W2.1mm_P2.50mm
D1, D2, D3, D4, D5: 1N5819; D_DO-41_SOD81_P10.16mm_Horizontal
D6, D7: LED; LED_D5.0mm_Clear
H1, H2, H3, H4: MountingHole; MountingHole_3.2mm_M3
J1: Conn_01x08; PinHeader_1x08_P2.54mm_Vertical
J2: Screw_Terminal_01x10; TerminalBlock_Phoenix_PT-1,5-10-5.0-H_1x10_P5.00mm_Horizont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
J3, J4: Conn_01x02; JST_XH_S2B-XH-A_1x02_P2.50mm_Horizontal
J5: 8P8C_Shielded; RJ45_Amphenol_54602-x08_Horizontal
J6: Conn_02x02_Top_Bottom; Molex_Mini-Fit_Jr_5569-04A2_2x02_P4.20mm_Horizontal
M1, M2, M3, M4, M5: Motor_Servo; PinHeader_1x03_P2.54mm_Vertical
Q1, Q2, Q3, Q4, Q5: Q_NMOS_GDS; TO-220-3_Vertical
R1, R2, R7, R8, R10: 1k; R_Axial_DIN0207_L6.3mm_D2.5mm_P10.16mm_Horizontal
R3, R4, R5, R6: 0R; R_Axial_DIN0207_L6.3mm_D2.5mm_P10.16mm_Horizontal
R9, R11: 10k; R_Axial_DIN0207_L6.3mm_D2.5mm_P10.16mm_Horizontal
R12, R13: 511R; R_Axial_DIN0207_L6.3mm_D2.5mm_P10.16mm_Horizontal
U1: MCP23017_SP; DIP-28_W7.62mm
U2: PCA9685PW; TSSOP-28_4.4x9.7mm_P0.65mm

Connections:
+12V: D1.1 (K), D2.1 (K), D3.1 (K), D4.1 (K), D5.1 (K), J2.2, J2.4, J2.6, J2.8, J2.10, J6.3
DSCL+: J5.4; also elsewhere on the board
DSCL-: J5.3; also elsewhere on the board
DSDA+: J5.5; also elsewhere on the board
DSDA-: J5.6; also elsewhere on the board
LED1: D6.2 (A), U1.26 (GPA5)
LED2: D7.2 (A), U1.27 (GPA6)
LIMIT_SW_L: J4.2, J5.1, R11.2
LIMIT_SW_R: J3.2, J5.8, R9.2
unnamed: D1.2 (A), J2.9, Q1.2 (D)
unnamed: D2.2 (A), J2.7, Q2.2 (D)
unnamed: D3.2 (A), J2.5, Q3.2 (D)
unnamed: D4.2 (A), J2.3, Q4.2 (D)
unnamed: D5.2 (A), J2.1, Q5.2 (D)
unnamed: D6.1 (K), R12.1
unnamed: D7.1 (K), R13.1
unnamed: J1.1, M1.1 (PWM), U2.6 (LED0)
unnamed: J1.2, M2.1 (PWM), U2.7 (LED1)
unnamed: J1.3, M3.1 (PWM), U2.8 (LED2)
unnamed: J1.4, M4.1 (PWM), U2.9 (LED3)
unnamed: J1.5, M5.1 (PWM), U2.10 (LED4)
unnamed: Q1.1 (G), R1.2
unnamed: Q2.1 (G), R2.2
unnamed: Q3.1 (G), R7.2
unnamed: Q4.1 (G), R8.2
unnamed: Q5.1 (G), R10.2
unnamed: R5.1, R6.1, U1.15 (A0)
unnamed: R1.1, U1.21 (GPA0)
unnamed: R2.1, U1.22 (GPA1)
unnamed: R7.1, U1.23 (GPA2)
unnamed: R8.1, U1.24 (GPA3)
unnamed: R10.1, U1.25 (GPA4)
unnamed: R3.1, R4.1, U2.1 (A0)
SCL: U1.12 (SCK), U2.26 (SCL); also elsewhere on the board
SDA: U1.13 (SDA), U2.27 (SDA); also elsewhere on the board

Notes on the sheet:
PWM GENERATOR
BOT-HOVEN Hand PCB Version 1
I/O EXPANDER
Drawn: Jascha Petersen
AS-BUILT
