bot-hoven/bot-hoven-electrical/v1/left_hand/left_hand.kicad_pcb

## KiCad design v1/left_hand/left_hand.kicad_pcb (continued)

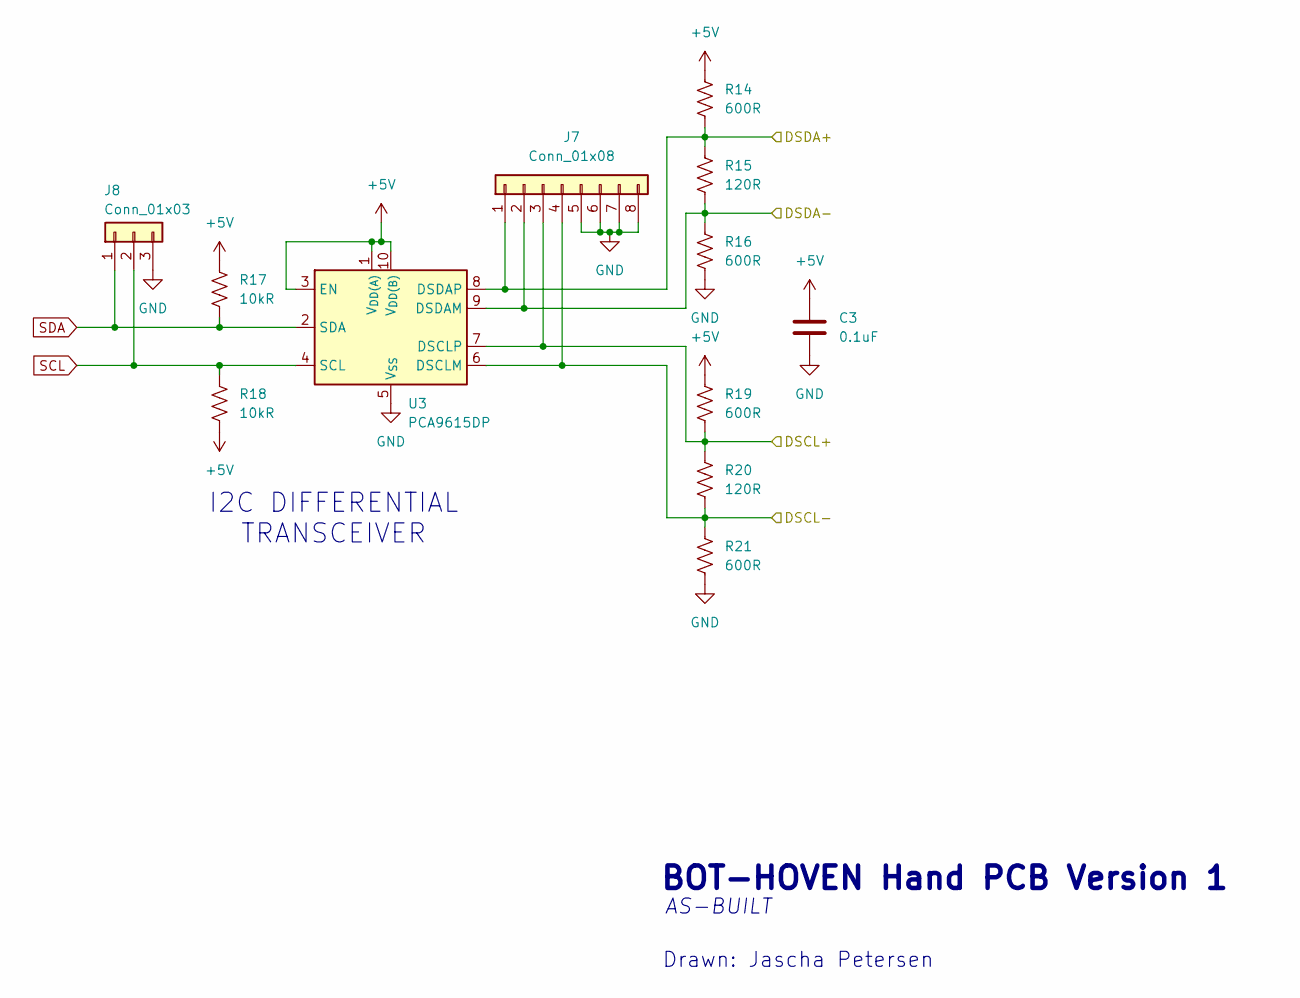
[picture p15: schematic diff_i2c.kicad_sch, Hand PCB Differential I2C]

Parts:
C3: 0.1uF; C_Disc_D3.4mm_W2.1mm_P2.50mm
J7: Conn_01x08; PinHeader_1x08_P2.54mm_Vertical
J8: Conn_01x03; PinHeader_1x03_P2.54mm_Vertical
R14, R16, R19, R21: 600R; R_Axial_DIN0207_L6.3mm_D2.5mm_P10.16mm_Horizontal
R15, R20: 120R; R_Axial_DIN0207_L6.3mm_D2.5mm_P10.16mm_Horizontal
R17, R18: 10kR; R_Axial_DIN0207_L6.3mm_D2.5mm_P10.16mm_Horizontal
U3: PCA9615DP; TSSOP-10_3x3mm_P0.5mm

Connections:
DSCL+: J7.3, R19.2, R20.1, U3.7 (DSCLP); also elsewhere on the board
DSCL-: J7.4, R20.2, R21.1, U3.6 (DSCLM); also elsewhere on the board
DSDA+: J7.1, R14.2, R15.1, U3.8 (DSDAP); also elsewhere on the board
DSDA-: J7.2, R15.2, R16.1, U3.9 (DSDAM); also elsewhere on the board
SCL: J8.2, R18.1, U3.4 (SCL); also elsewhere on the board
SDA: J8.1, R17.2, U3.2 (SDA); also elsewhere on the board

Notes on the sheet:
AS-BUILT
Drawn: Jascha Petersen
BOT-HOVEN Hand PCB Version 1
I2C DIFFERENTIAL TRANSCEIVER

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
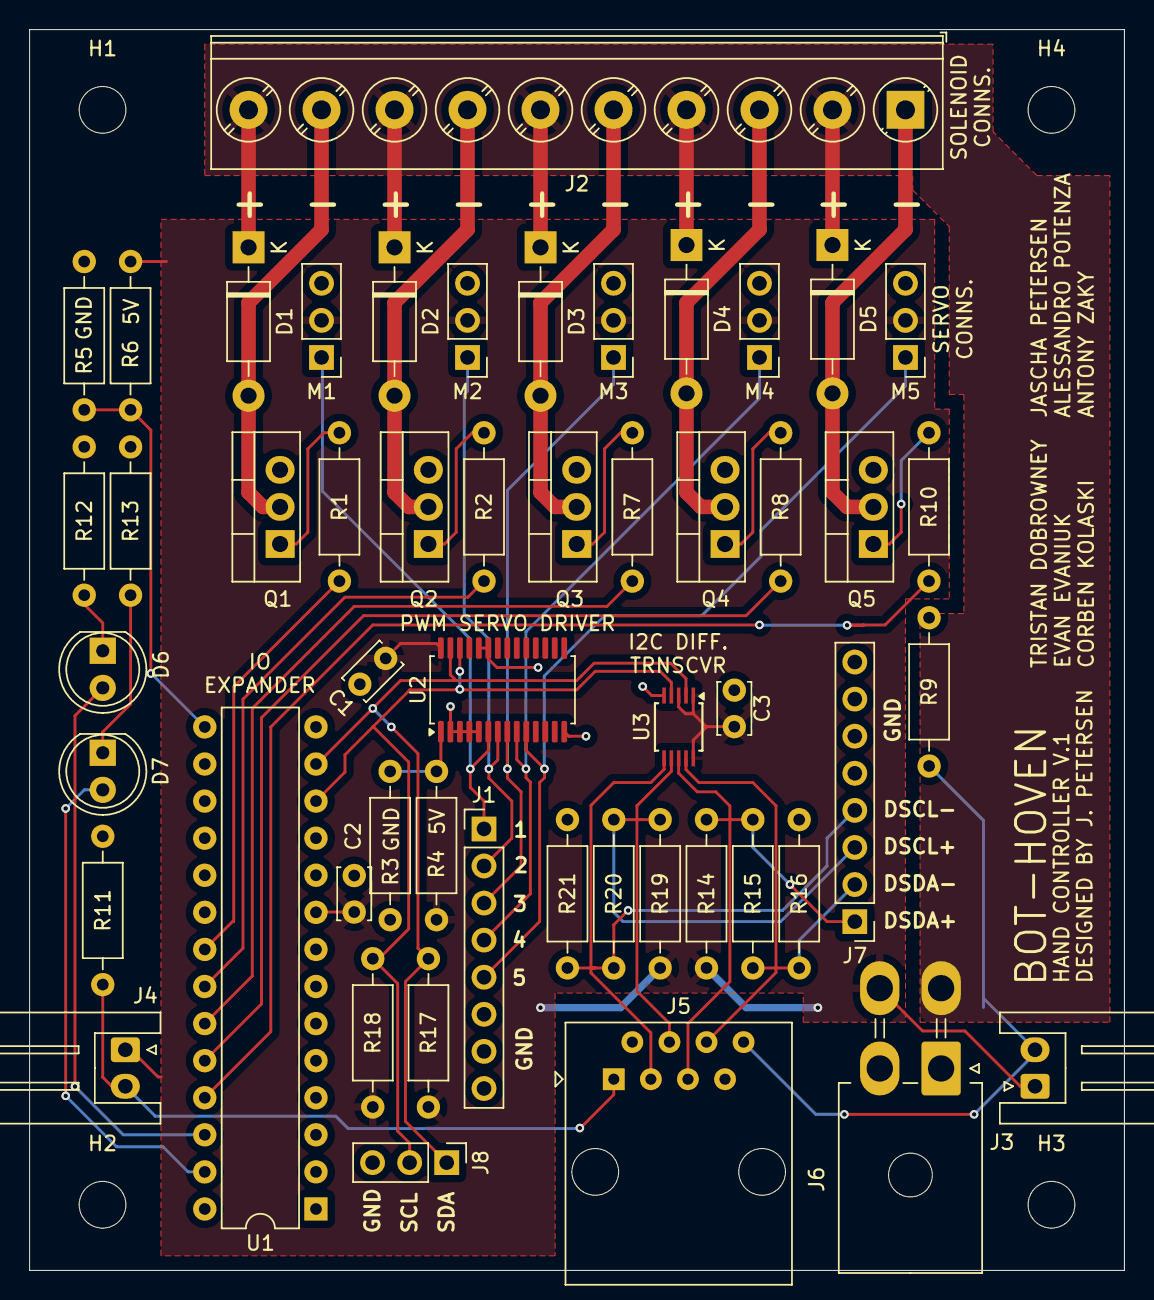
[picture p16: board left_hand.kicad_pcb from above]

Board: 2 copper layers, 75.0 x 85.0 mm, 56 parts (0 on the bottom side), 37 nets.
