bot-hoven/bot-hoven-electrical/v1/mainpcb/mainpcb.kicad_pcb

## KiCad design v1/mainpcb/mainpcb.kicad_pcb (2024-12-06, an earlier design)

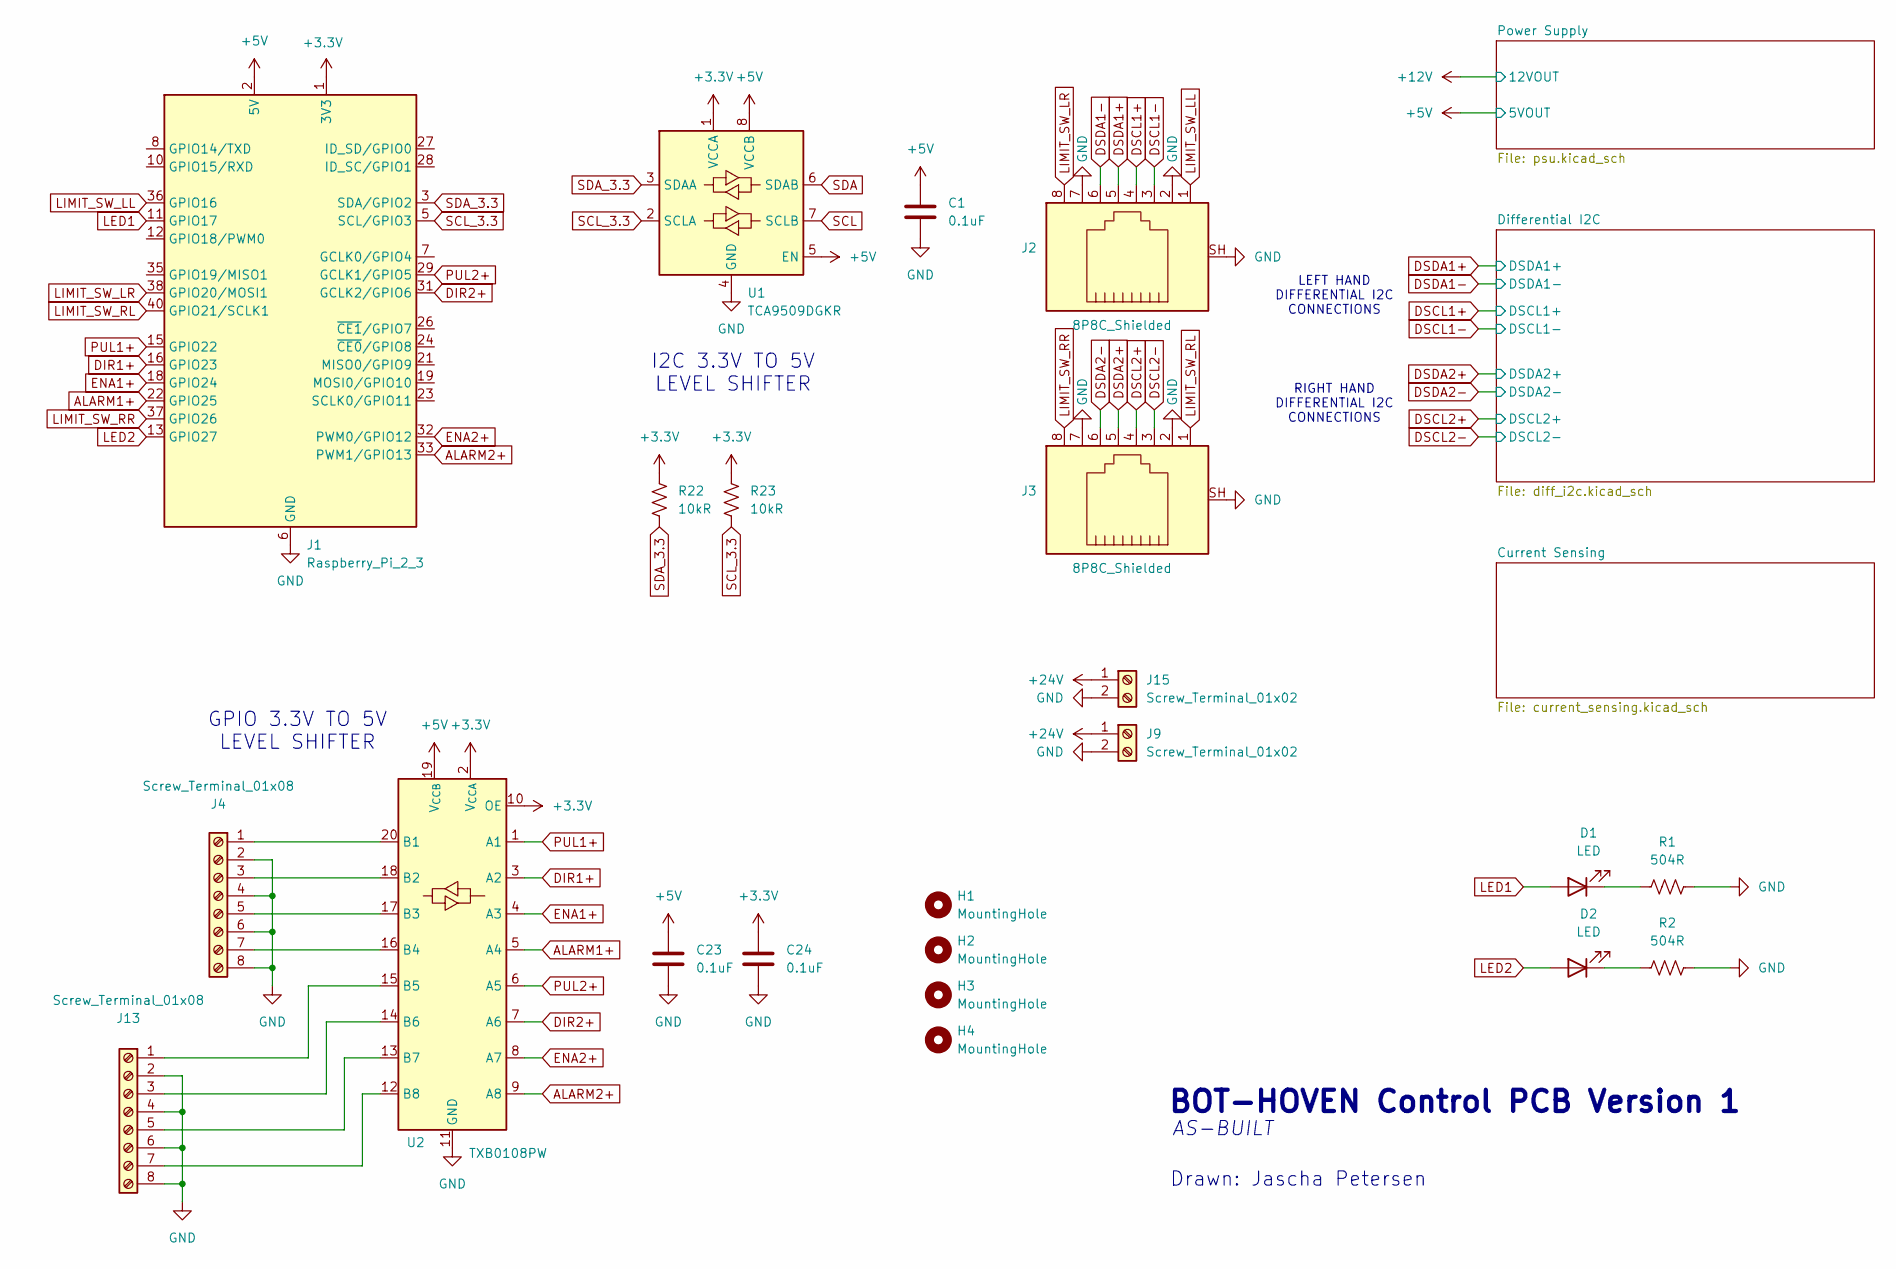
[picture p17: schematic mainpcb.kicad_sch, Control PCB Main]

Parts:
C1, C23, C24: 0.1uF; C_Rect_L4.6mm_W2.0mm_P2.50mm_MKS02_FKP02
D1, D2: LED; LED_D5.0mm_Clear
H1, H2, H3, H4: MountingHole; MountingHole_4.3mm_M4
J1: Raspberry_Pi_2_3; PinHeader_2x20_P2.54mm_Vertical
J2, J3: 8P8C_Shielded; RJ45_Amphenol_54602-x08_Horizontal
J4, J13: Screw_Terminal_01x08; TerminalBlock_Phoenix_PT-1,5-8-5.0-H_1x08_P5.00mm_Horizontal
J9, J15: Screw_Terminal_01x02; TerminalBlock_Phoenix_PT-1,5-2-5.0-H_1x02_P5.00mm_Horizontal
R1, R2: 504R; R_Axial_DIN0207_L6.3mm_D2.5mm_P10.16mm_Horizontal
R22, R23: 10kR; R_Axial_DIN0207_L6.3mm_D2.5mm_P10.16mm_Horizontal
U1: TCA9509DGKR; VSSOP-8_3x3mm_P0.65mm
U2: TXB0108PW; TSSOP-20_4.4x6.5mm_P0.65mm

Connections:
+3.3V: C24.1, J1.1 (3V3), J1.17 (3V3), R22.1, R23.1, U1.1 (VCCA), U2.2 (V_{CCA}), U2.10 (OE)
+5V: C1.1, C23.1, J1.2 (5V), J1.4 (5V), U1.5 (EN), U1.8 (VCCB), U2.19 (V_{CCB}); also elsewhere on the board
+24V: J9.1, J15.1; also elsewhere on the board
ALARM1+: J1.22 (GPIO25), U2.5 (A4)
ALARM2+: J1.33 (PWM1/GPIO13), U2.9 (A8)
DIR1+: J1.16 (GPIO23), U2.3 (A2)
DIR2+: J1.31 (GCLK2/GPIO6), U2.7 (A6)
DSCL1+: J2.4; also elsewhere on the board
DSCL1-: J2.3; also elsewhere on the board
DSCL2+: J3.4; also elsewhere on the board
DSCL2-: J3.3; also elsewhere on the board
DSDA1+: J2.5; also elsewhere on the board
DSDA1-: J2.6; also elsewhere on the board
DSDA2+: J3.5; also elsewhere on the board
DSDA2-: J3.6; also elsewhere on the board
ENA1+: J1.18 (GPIO24), U2.4 (A3)
ENA2+: J1.32 (PWM0/GPIO12), U2.8 (A7)
GND: C1.2, C23.2, C24.2, J1.6 (GND), J1.9 (GND), J1.14 (GND), J1.20 (GND), J1.25 (GND), J1.30 (GND), J1.34 (GND), J1.39 (GND), J2.2, J2.7, J2.SH, J3.2, J3.7, J3.SH, J4.2, J4.4, J4.6, J4.8, J9.2, J13.2, J13.4, J13.6, J13.8, J15.2, R1.2, R2.2, U1.4 (GND), U2.11 (GND); also elsewhere on the board
LED1: D1.2 (A), J1.11 (GPIO17)
LED2: D2.2 (A), J1.13 (GPIO27)
LIMIT_SW_LL: J1.36 (GPIO16), J2.1
LIMIT_SW_LR: J1.38 (GPIO20/MOSI1), J2.8
LIMIT_SW_RL: J1.40 (GPIO21/SCLK1), J3.1
LIMIT_SW_RR: J1.37 (GPIO26), J3.8
unnamed: D1.1 (K), R1.1
unnamed: D2.1 (K), R2.1
unnamed: J4.1, U2.20 (B1)
unnamed: J4.3, U2.18 (B2)
unnamed: J4.5, U2.17 (B3)
unnamed: J4.7, U2.16 (B4)
unnamed: J13.1, U2.15 (B5)
unnamed: J13.3, U2.14 (B6)
unnamed: J13.5, U2.13 (B7)
unnamed: J13.7, U2.12 (B8)
PUL1+: J1.15 (GPIO22), U2.1 (A1)
PUL2+: J1.29 (GCLK1/GPIO5), U2.6 (A5)
SCL: U1.7 (SCLB); also elsewhere on the board
SCL_3.3: J1.5 (SCL/GPIO3), R23.2, U1.2 (SCLA)
SDA: U1.6 (SDAB); also elsewhere on the board
SDA_3.3: J1.3 (SDA/GPIO2), R22.2, U1.3 (SDAA)

Notes on the sheet:
BOT-HOVEN Control PCB Version 1
I2C 3.3V TO 5V LEVEL SHIFTER
RIGHT HAND DIFFERENTIAL I2C CONNECTIONS
LEFT HAND DIFFERENTIAL I2C CONNECTIONS
AS-BUILT
Drawn: Jascha Petersen
GPIO 3.3V TO 5V LEVEL SHIFTER

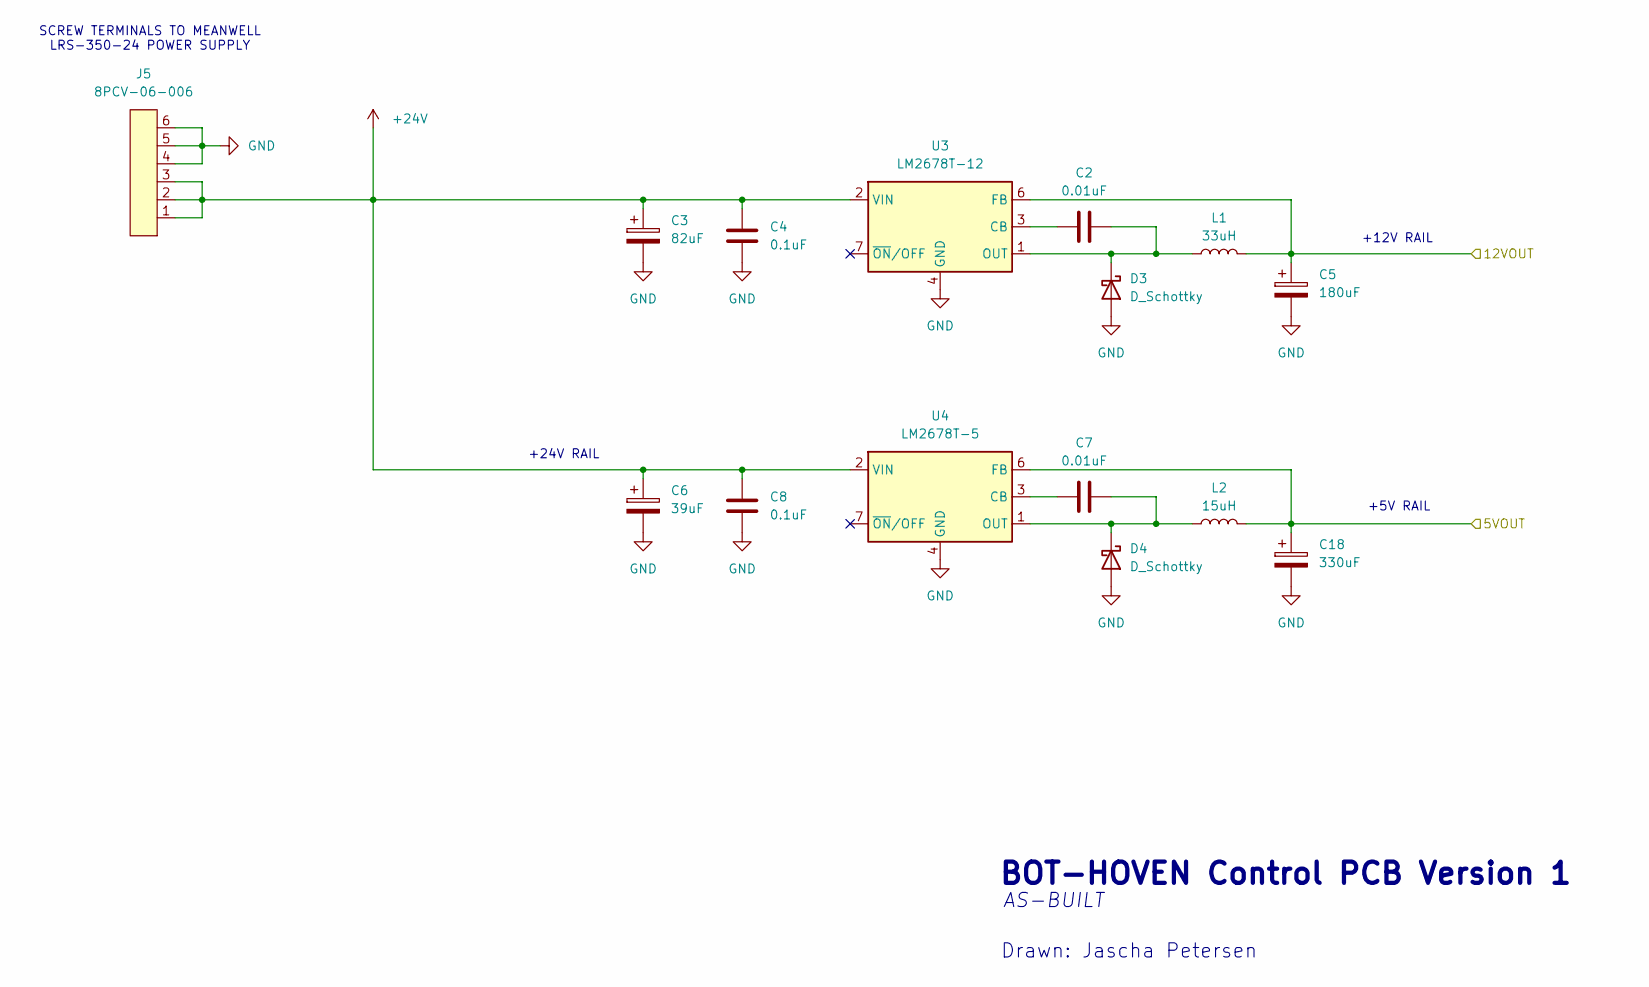
[picture p18: schematic psu.kicad_sch, Control PCB PSU]

Parts:
C2, C7: 0.01uF; C_Rect_L4.0mm_W2.5mm_P2.50mm
C3: 82uF; CP_Radial_D8.0mm_P3.50mm
C4, C8: 0.1uF; C_Rect_L4.0mm_W2.5mm_P2.50mm
C5: 180uF; CP_Radial_D8.0mm_P3.50mm
C6: 39uF; CP_Radial_D8.0mm_P3.50mm
C18: 330uF; C_Radial_D10.0mm_H12.5mm_P5.00mm
D3, D4: D_Schottky; D_DO-27_P15.24mm_Horizontal
J5: 8PCV-06-006; Terminal_Block_8PCV-06-006
L1: 33uH; L_Toroid_Vertical_L31.8mm_W15.9mm_P13.50mm_Bourns_5700
L2: 15uH; L_Toroid_Vertical_L31.8mm_W15.9mm_P13.50mm_Bourns_5700
U3: LM2678T-12; TO-220-7_P2.54x3.7mm_StaggerOdd_Lead3.8mm_Vertical
U4: LM2678T-5; TO-220-7_P2.54x3.7mm_StaggerOdd_Lead3.8mm_Vertical

Connections:
+5V: C18.1, L2.2, U4.6 (FB); also elsewhere on the board
+12V: C5.1, L1.2, U3.6 (FB); also elsewhere on the board
+24V: C3.1, C4.1, C6.1, C8.1, J5.1, J5.2, J5.3, U3.2 (VIN), U4.2 (VIN); also elsewhere on the board
GND: C3.2, C4.2, C5.2, C6.2, C8.2, C18.2, D3.2 (A), D4.2 (A), J5.4, J5.5, J5.6, U3.4 (GND), U3.7 (~ON/OFF), U4.4 (GND), U4.7 (~ON/OFF); also elsewhere on the board
unnamed: C2.2, D3.1 (K), L1.1, U3.1 (OUT)
unnamed: C7.2, D4.1 (K), L2.1, U4.1 (OUT)
unnamed: C2.1, U3.3 (CB)
unnamed: C7.1, U4.3 (CB)

Notes on the sheet:
Drawn: Jascha Petersen
AS-BUILT
SCREW TERMINALS TO MEANWELL LRS-350-24 POWER SUPPLY
+24V RAIL
+12V RAIL
+5V RAIL
BOT-HOVEN Control PCB Version 1

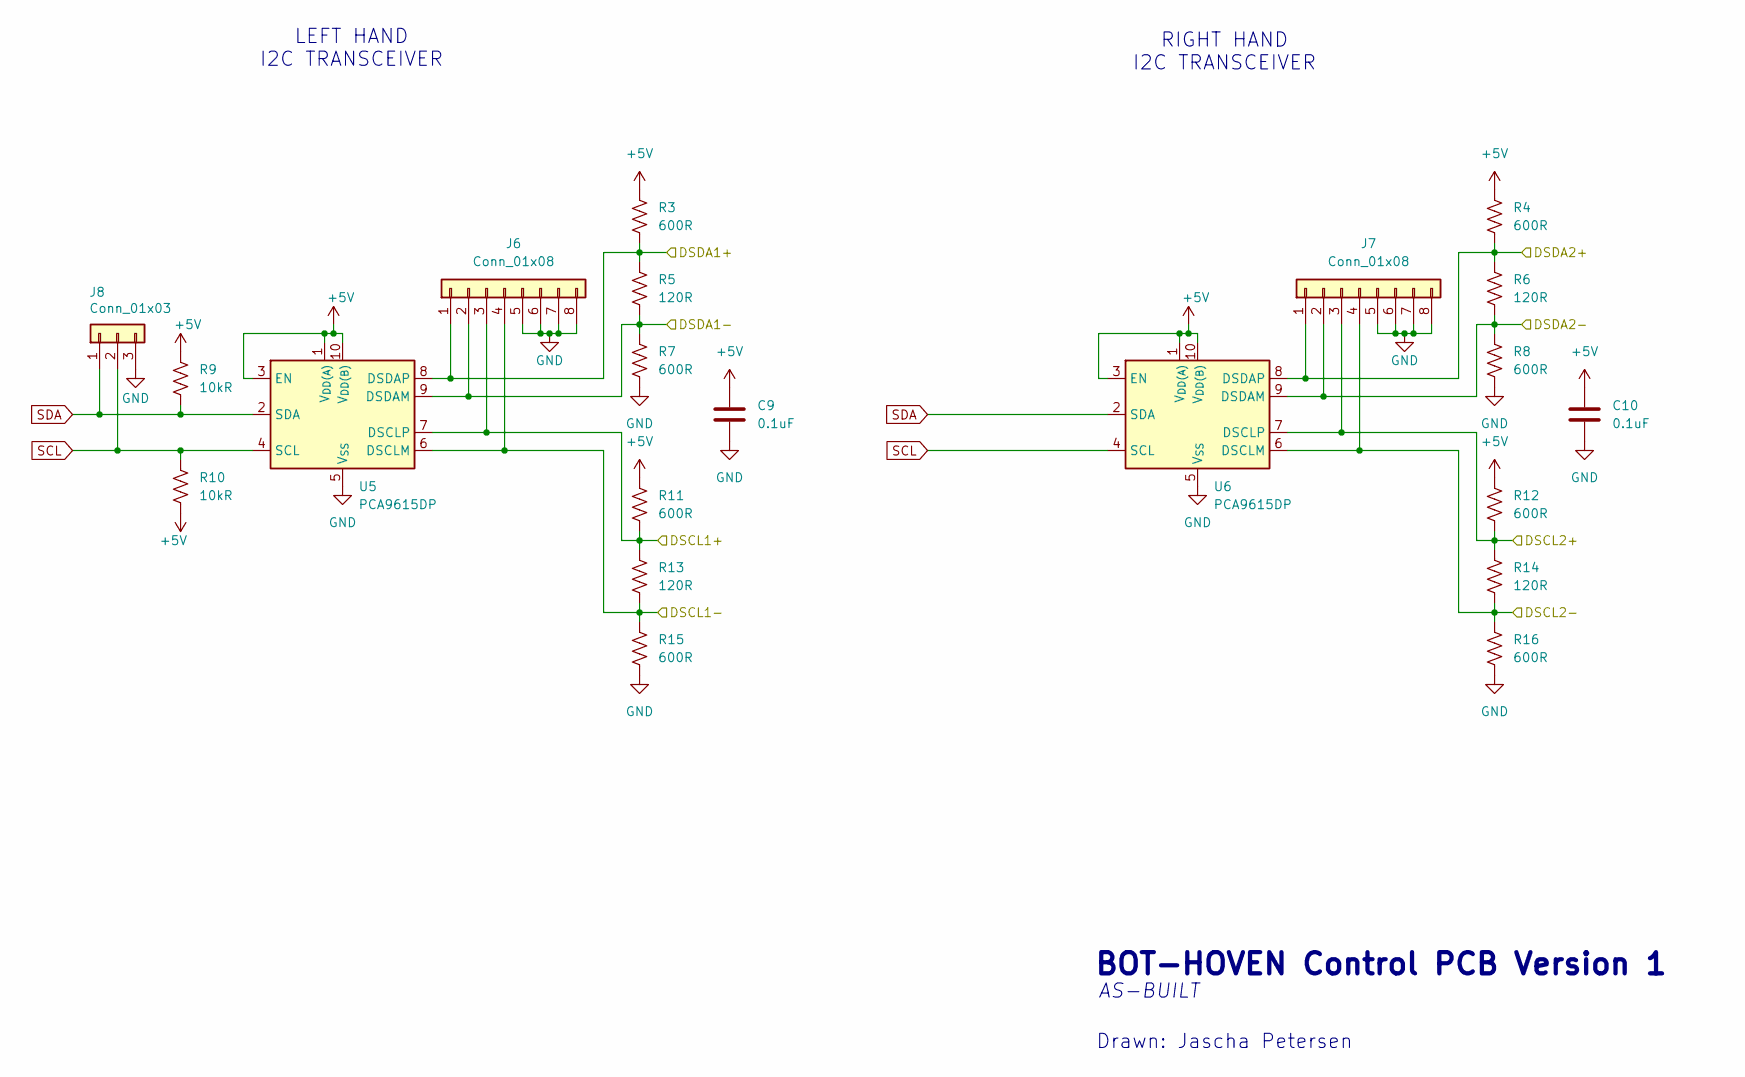
[picture p19: schematic diff_i2c.kicad_sch, Control PCB Differential I2C]

Parts:
C9, C10: 0.1uF; C_Rect_L4.6mm_W2.0mm_P2.50mm_MKS02_FKP02
J6, J7: Conn_01x08; PinHeader_1x08_P2.54mm_Vertical
J8: Conn_01x03; PinHeader_1x03_P2.54mm_Vertical
R3, R4, R7, R8, R11, R12, R15, R16: 600R; R_Axial_DIN0207_L6.3mm_D2.5mm_P10.16mm_Horizontal
R5, R6, R13, R14: 120R; R_Axial_DIN0207_L6.3mm_D2.5mm_P10.16mm_Horizontal
R9, R10: 10kR; R_Axial_DIN0207_L6.3mm_D2.5mm_P10.16mm_Horizontal
U5, U6: PCA9615DP; TSSOP-10_3x3mm_P0.5mm

Connections:
+5V: C9.1, C10.1, R3.1, R4.1, R9.1, R10.2, R11.1, R12.1, U5.1 (V_{DD(A)}), U5.3 (EN), U5.10 (V_{DD(B)}), U6.1 (V_{DD(A)}), U6.3 (EN), U6.10 (V_{DD(B)}); also elsewhere on the board
DSCL1+: J6.3, R11.2, R13.1, U5.7 (DSCLP); also elsewhere on the board
DSCL1-: J6.4, R13.2, R15.1, U5.6 (DSCLM); also elsewhere on the board
DSCL2+: J7.3, R12.2, R14.1, U6.7 (DSCLP); also elsewhere on the board
DSCL2-: J7.4, R14.2, R16.1, U6.6 (DSCLM); also elsewhere on the board
DSDA1+: J6.1, R3.2, R5.1, U5.8 (DSDAP); also elsewhere on the board
DSDA1-: J6.2, R5.2, R7.1, U5.9 (DSDAM); also elsewhere on the board
DSDA2+: J7.1, R4.2, R6.1, U6.8 (DSDAP); also elsewhere on the board
DSDA2-: J7.2, R6.2, R8.1, U6.9 (DSDAM); also elsewhere on the board
GND: C9.2, C10.2, J6.5, J6.6, J6.7, J6.8, J7.5, J7.6, J7.7, J7.8, J8.3, R7.2, R8.2, R15.2, R16.2, U5.5 (V_{SS}), U6.5 (V_{SS}); also elsewhere on the board
SCL: J8.2, R10.1, U5.4 (SCL), U6.4 (SCL); also elsewhere on the board
SDA: J8.1, R9.2, U5.2 (SDA), U6.2 (SDA); also elsewhere on the board

Notes on the sheet:
AS-BUILT
BOT-HOVEN Control PCB Version 1
Drawn: Jascha Petersen
LEFT HAND I2C TRANSCEIVER
RIGHT HAND I2C TRANSCEIVER

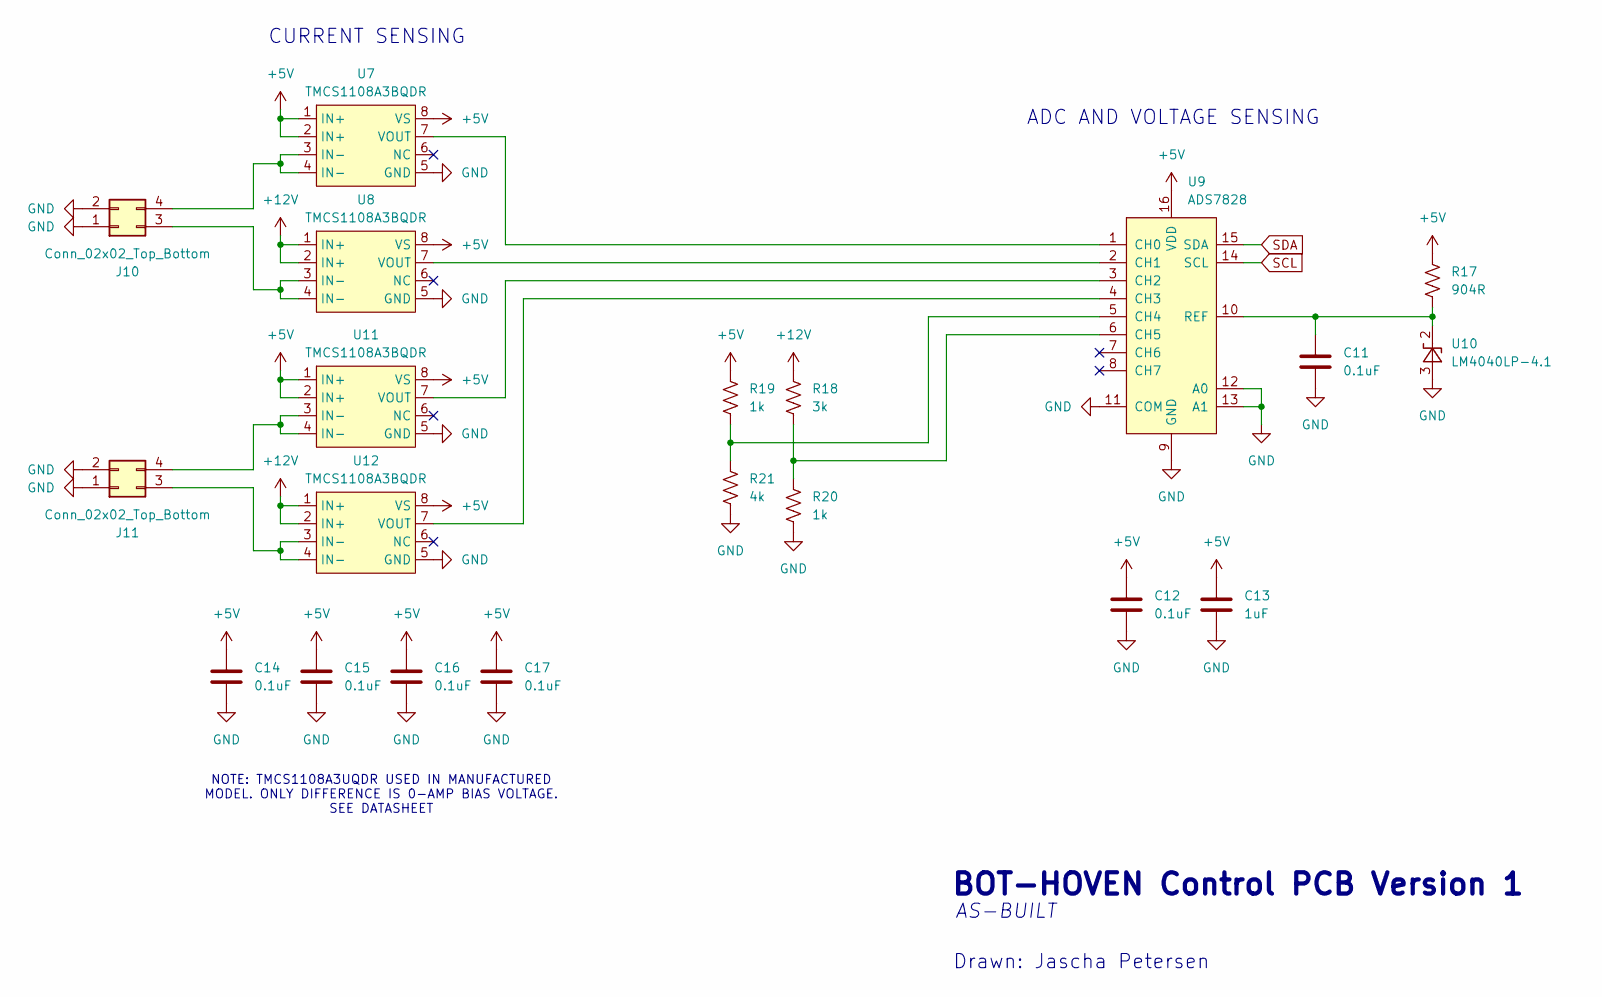
[picture p20: schematic current_sensing.kicad_sch, Control PCB Current Sensing]

Parts:
C11, C12, C14, C15, C16, C17: 0.1uF; C_Rect_L4.6mm_W2.0mm_P2.50mm_MKS02_FKP02
C13: 1uF; C_Rect_L4.6mm_W2.0mm_P2.50mm_MKS02_FKP02
J10, J11: Conn_02x02_Top_Bottom; Molex_Mini-Fit_Jr_5569-04A2_2x02_P4.20mm_Horizontal
R17: 904R; R_Axial_DIN0207_L6.3mm_D2.5mm_P10.16mm_Horizontal
R18: 3k; R_Axial_DIN0207_L6.3mm_D2.5mm_P10.16mm_Horizontal
R19, R20: 1k; R_Axial_DIN0207_L6.3mm_D2.5mm_P10.16mm_Horizontal
R21: 4k; R_Axial_DIN0207_L6.3mm_D2.5mm_P10.16mm_Horizontal
U7, U8, U11, U12: TMCS1108A3BQDR; SOIC-8_3.9x4.9mm_P1.27mm
U9: ADS7828; TSSOP-16_4.4x5mm_P0.65mm
U10: LM4040LP-4.1; TO-92_Inline

Connections:
+5V: C12.1, C13.1, C14.1, C15.1, C16.1, C17.1, R17.1, R19.1, U7.1 (IN+), U7.2 (IN+), U7.8 (VS), U8.8 (VS), U9.16 (VDD), U11.1 (IN+), U11.2 (IN+), U11.8 (VS), U12.8 (VS); also elsewhere on the board
+12V: R18.1, U8.1 (IN+), U8.2 (IN+), U12.1 (IN+), U12.2 (IN+); also elsewhere on the board
GND: C11.2, C12.2, C13.2, C14.2, C15.2, C16.2, C17.2, J10.1, J10.2, J11.1, J11.2, R20.2, R21.2, U7.5 (GND), U8.5 (GND), U9.9 (GND), U9.11 (COM), U9.12 (A0), U9.13 (A1), U10.3 (A), U11.5 (GND), U12.5 (GND); also elsewhere on the board
unnamed: J10.3, U8.3 (IN-), U8.4 (IN-)
unnamed: J10.4, U7.3 (IN-), U7.4 (IN-)
unnamed: J11.3, U12.3 (IN-), U12.4 (IN-)
unnamed: J11.4, U11.3 (IN-), U11.4 (IN-)
unnamed: U7.7 (VOUT), U9.1 (CH0)
unnamed: U8.7 (VOUT), U9.2 (CH1)
unnamed: R19.2, R21.1, U9.5 (CH4)
unnamed: R18.2, R20.1, U9.6 (CH5)
unnamed: C11.1, R17.2, U9.10 (REF), U10.2 (K)
unnamed: U9.3 (CH2), U11.7 (VOUT)
unnamed: U9.4 (CH3), U12.7 (VOUT)
SCL: U9.14 (SCL); also elsewhere on the board
SDA: U9.15 (SDA); also elsewhere on the board

Notes on the sheet:
AS-BUILT
Drawn: Jascha Petersen
BOT-HOVEN Control PCB Version 1
ADC AND VOLTAGE SENSING
CURRENT SENSING
NOTE: TMCS1108A3UQDR USED IN MANUFACTURED MODEL. ONLY DIFFERENCE IS 0-AMP BIAS VOLTAGE. SEE DATASHEET

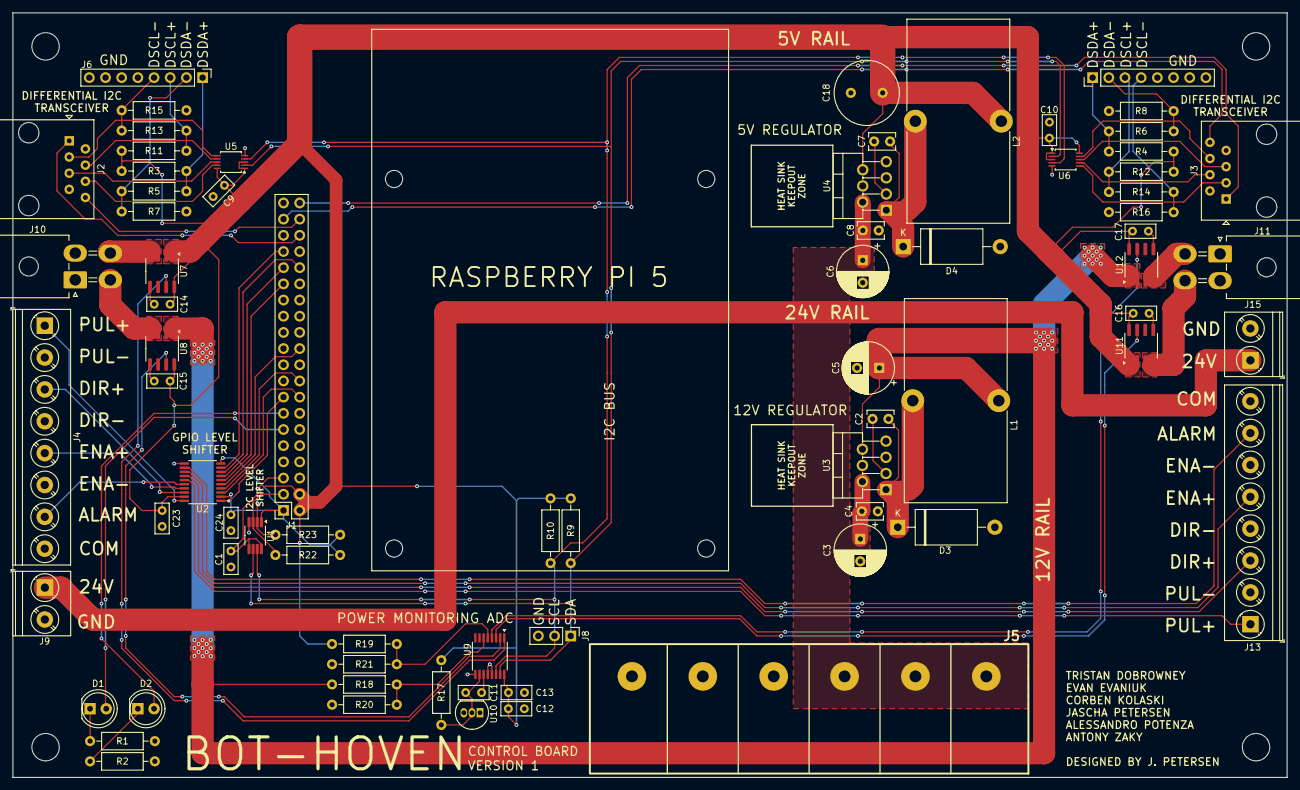
[picture p21: board mainpcb.kicad_pcb from above]

Board: 2 copper layers, 200.0 x 120.0 mm, 78 parts (0 on the bottom side), 56 nets.
