bot-hoven/bot-hoven-electrical/(commit log)

2024-09-24 Added KiCad project
    Basic power supply design is complete
    [mainpcb.kicad_pcb, mainpcb.kicad_sch, psu.kicad_sch]
2024-10-06 Added PSU terminal block symbol
    Also created bh_part_library for custom modelled parts used in the bot-hoven project.
    [mainpcb.kicad_sch, psu.kicad_sch]
2024-10-07 Some hand components, PSU changes
    Updated PSU to 24V rail regulated to 5V and 3.3V. Hopefully we won't need a 12V rail. Made some part selections, added IO expander for hand, mosfet, made solenoid symbol.
    [left_hand.kicad_pcb, left_hand.kicad_sch, mainpcb.kicad_sch, psu.kicad_sch]
2024-10-07 Added PCA9615 differential I2C buffer
    [left_hand.kicad_sch, mainpcb.kicad_sch]
2024-10-07 Added PCA9685 PWM generator IC
    [left_hand.kicad_sch]
2024-10-11 Added 12V power rail and regulator
    [left_hand.kicad_sch, mainpcb.kicad_sch, psu.kicad_sch]
2024-10-11 Created LM2678 12V regulator symbol
    Updated 12V regulator circuit
    [mainpcb.kicad_sch, psu.kicad_sch]
2024-10-12 Added TCA9517 I2C level shifter
    [mainpcb.kicad_sch]
2024-10-15 I2C diff. and single side bus changes
    Added differential termination on each end. Todo: determine maximum differential bias voltage. Added pull up resistors for I2C lines.
    Added decoupling caps.
    [left_hand.kicad_sch, mainpcb.kicad_sch]
2024-10-16 Added debug headers to stuff
    Added debug headers to I2C single ended lines and differential lines
    [left_hand.kicad_sch, mainpcb.kicad_sch]
2024-11-01 Added ICs
    Added ADC IC
    Switched to schottky flyback diode for better response times
    [left_hand.kicad_sch, untitled.kicad_sch]
2024-11-08 Added gate resistors to MOSFETs
    [left_hand.kicad_sch]
2024-11-19 I2C transceivers, sheet hierarchy changes
    Added I2C transceivers for both hands on the controller side, also changed sheet hierarchy to modularize controller board sheet somewhat
    [diff_i2c.kicad_sch, left_hand.kicad_sch, mainpcb.kicad_sch, psu.kicad_sch]
2024-11-19 Added GPIO level shifter
    Added general purpose TXB0108 level shifter to translate from 3.3V to 5V logic between the RPi and motor driver
    Future connections will be for limit switches etc.
    [diff_i2c.kicad_sch, mainpcb.kicad_sch]
2024-11-19 Tie output enable pin on TXB0108 to 3.3V
    [diff_i2c.kicad_sch, mainpcb.kicad_sch]
2024-11-27 Major update
    Hand PCB mostly complete
    [diff_i2c.kicad_sch, left_hand.kicad_pcb, left_hand.kicad_sch, mainpcb.kicad_sch]
2024-11-27 Added current and voltage sensing on control board
    [diff_i2c.kicad_sch, left_hand.kicad_pcb, left_hand.kicad_sch, mainpcb.kicad_pcb, mainpcb.kicad_sch, psu.kicad_sch, untitled.kicad_sch]
2024-12-02 Added limit switches to hand and readme
    [current_sensing.kicad_sch, diff_i2c.kicad_sch, left_hand.kicad_pcb, left_hand.kicad_sch, mainpcb.kicad_sch, psu.kicad_sch]
2024-12-03 Added screw terminals etc for both stepper drivers
    [diff_i2c.kicad_sch, left_hand.kicad_sch, mainpcb.kicad_sch]
2024-12-03 Started layout of control board
    [diff_i2c.kicad_sch, left_hand.kicad_pcb, left_hand.kicad_sch, mainpcb.kicad_pcb, mainpcb.kicad_sch, psu.kicad_sch]
2024-12-04 Continued control board layout
    [current_sensing.kicad_sch, left_hand.kicad_pcb, mainpcb.kicad_pcb, mainpcb.kicad_sch]
2024-12-05 Started signal track layout of control PCB
    [current_sensing.kicad_sch, mainpcb.kicad_pcb, mainpcb.kicad_sch]
2024-12-05 Completed control board layout
    [current_sensing.kicad_sch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]
2024-12-06 As-Produced commit
    This commit contains the PCBs as they were sent to the manufacturer
    [current_sensing.kicad_sch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]
2025-01-08 Updated differential termination resistor values
    [diff_i2c.kicad_sch]
2025-01-31 Version 1 AS-BUILT commit
    This commit has the schematics of version 1 of the system AS IT WAS BUILT
    [diff_i2c.kicad_sch, left_hand.kicad_sch, mainpcb.kicad_sch, psu.kicad_sch]
2025-01-31 Added drawing information boxes
    [current_sensing.kicad_sch, diff_i2c.kicad_sch, left_hand.kicad_sch, mainpcb.kicad_sch, psu.kicad_sch]
2025-01-31 Added PDF schematic exports
    [current_sensing.kicad_sch, diff_i2c.kicad_sch, mainpcb.kicad_sch, psu.kicad_sch]
2025-02-07 Starting hardware version 2
    Created version 2 control board project file
    Added raspberry pi pico symbol and footprint
    Both probably need work but will do for now
    Restructured directories
    [control_pcb.kicad_pcb, control_pcb.kicad_sch, current_sensing.kicad_sch, diff_i2c.kicad_sch, differential_i2c.kicad_sch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]
2025-02-09 Doing stuff
    [control_pcb.kicad_sch, current_sensing.kicad_sch]
2025-02-09 Added TXU0304 level shifter
    Added unidirectional SPI compatible level shifter
    [control_pcb.kicad_sch]
2025-02-09 Preliminary V2 schematics
    [control_pcb.kicad_sch, differential_i2c.kicad_sch, hand_pcb.kicad_pcb, hand_pcb.kicad_sch, solenoids.kicad_sch]
2025-02-10 Added hand ADCs
    Subject to change without notice
    [hand_pcb.kicad_sch]
2025-02-11 Replaced hand ADCs with ADS7138
    [hand_pcb.kicad_sch]
2025-02-15 Doing some things
    Crossing some ts and dotting some is. Making v3 of the BOM.
    [control_pcb.kicad_sch, current_sensing.kicad_sch, hand_pcb.kicad_sch]
2025-02-16 Switched logic level shifting from SPI to GPIO
    RPi Pico uses 5V power in but has an internal 3.3V regulator so uses 3.3V logic. Level shifting not required for SPI then but required for GPIO pins going to stepper control outputs
    [control_pcb.kicad_sch]
2025-03-02 Doing some things
    [control_pcb.kicad_pcb, control_pcb.kicad_sch, hand_pcb.kicad_pcb, hand_pcb.kicad_sch]
2025-03-04 Doing more things
    [control_pcb-B_Cu.gbr, control_pcb-B_Mask.gbr, control_pcb-B_Paste.gbr, control_pcb-B_Silkscreen.gbr, control_pcb-Edge_Cuts.gbr, control_pcb-F_Cu.gbr, control_pcb-F_Mask.gbr, control_pcb-F_Paste.gbr]
2025-03-04 Doing more things 2
    [control_pcb.kicad_sch, hand_pcb.kicad_pcb]
2025-03-05 Version 2 As-Ordered commit
    Minor changes to polish things up.
    Version 2 is a major revision from the last revision, version 1. There are now 10 servo channels in addition to the 5 solenoid channels, and ADC feedback for those servos.
    [control_pcb-B_Cu.gbr, control_pcb-B_Mask.gbr, control_pcb-B_Paste.gbr, control_pcb-B_Silkscreen.gbr, control_pcb-Edge_Cuts.gbr, control_pcb-F_Cu.gbr, control_pcb-F_Mask.gbr, control_pcb-F_Paste.gbr]
